longhialberto677-gif/stm32f103-foc/硬件/讲义/01-主课/00-课程进度与文件索引.md

# FOC 硬件课程 · 课程骨架（细化版）

> 讲课原则：
> ① **一节课只讲一件事**，讲透再走。
> ② 每节课都按 **遇到什么问题 → 所以要干什么 → 于是有了什么电路** 这条线。
> ③ 看不懂的地方立刻停下来重讲，不往前赶。
>
> 难度标记：🟢 轻松 / 🟡 需要动脑 / 🔴 硬骨头

---

## 进度总表

> 状态：✅ 已讲完并落盘 ｜ 📄 已落盘（合并成一个大文件） ｜ ⬜ 未讲

| 课 | 标题 | 讲什么 | 难度 | 状态 |
|---|---|---|---|---|
| **0** | MOS 管与三极管补课 | 电控开关的基础 | 🟡 | ✅ `00-MOS管与三极管补课.md` |
| — | 专题：高边低边与四种接法 | 开关装在哪里 | 🔴 | ✅ `专题-高边低边与四种接法.md` |
| — | 专题：三极管供电与 MCU 接法 | 三极管怎么接线 | 🟡 | ✅ `专题-三极管供电与MCU接法.md` |
| — | 专题：为什么 MOS 需要驱动 | 为什么要驱动芯片 | 🟡 | ✅ `专题-为什么MOS需要驱动.md` |
| **1-1** | 从哪里弄到电 + 整块板的地图 | 电池、接口、全板一览 | 🟢 | ✅ `第01课-电源输入.md` |
| **1-2** | 怎么保护自己（保险丝 + TVS） | 短路、尖峰怎么防 | 🟢 | ✅ `第1-2节-保护自己.md` |
| **1-3** | 怎么开关 + 怎么防接反（背靠背 P-MOS） | 第 0 课的实战 | 🔴 | ✅ `第1-3节-开关与防接反.md` |
| **1-4** | 把 12V 稳住（电容 + 地） | 滤波、PGND/GND | 🟡 | ✅ `第1-4节-稳住12V.md` |
| **2-1** | 为什么不能用电阻分压 | 排除错误方案 | 🟢 | ✅ `第2-1节-为什么不能用电阻分压.md` |
| **2-2** | 开关降压：12V → 5V | TPS5430 | 🔴 | ✅ `第2-2节-开关降压12V到5V.md` |
| **2-3** | 线性稳压：5V → 3.3V（数字） | AMS1117 | 🟡 | ✅ `第2-3节-线性稳压5V到3.3V.md` |
| **2-4** | 为什么要第二颗 LDO（模拟） | 干净的 3.3V | 🔴 | ✅ `第2-4节-为什么要第二颗LDO.md` |
| **3-1** | 大脑要多快 | 72MHz 从哪来 | 🟡 | 📄 `第3课-大脑.md` |
| **3-2** | 为什么必须用 TIM1 | 互补输出 + 死区 + 刹车 | 🔴 | 📄 `第3课-大脑.md` |
| **3-3** | 36 个引脚怎么分配 | 引脚规划表 | 🟡 | 📄 `第3课-大脑.md` |
| **4-1** | 3.3V 信号怎么推动 12V 的 MOS | 驱动芯片的活 | 🟡 | ✅ `第4-1节-推不动MOS怎么办.md` |
| **4-2** | 自举：上管的电从哪来 | 浮动栅压 | 🔴 | ✅ `第4-2节-自举.md` |
| **4-3** | 三相桥 + 采样电阻 | 功率级全貌 | 🟡 | ✅ `第4-3节-三相桥与采样电阻.md` |
| **5-1** | 为什么要差分放大 | 脏地上的小信号 | 🔴 | 📄 `第5课-电流采样.md` |
| **5-2** | 为什么要有 1.65V 偏置 | 负电流也要能测 | 🔴 | 📄 `第5课-电流采样.md` |
| **6-1** | 为什么时机比精度重要 | 抓拍的道理 | 🟡 | 📄 `第6课-采样时机.md` |
| **6-2** | 哪个时刻最好 | 谷底窗口 | 🟡 | 📄 `第6课-采样时机.md` |
| **6-3** | 怎么让 ADC 自动启动 | TRGO 硬件触发 | 🔴 | 📄 `第6课-采样时机.md` |
| **6-4** | 时序计算 + 三个坑 | 第一版参数 | 🟡 | 📄 `第6课-采样时机.md` |
| **7** | 屏幕、按键、LED、USB、CAN、编码器接口 | 人机与组网 | 🟢 | ✅ `第7课-外设与通讯.md` |
| **8** | 从 0 到电机转起来的调试路线 | 动手清单 + 10 个坑 | 🟡 | ✅ `第8课-调试路线图.md` |

**🎉 硬件主课已全部讲完（第 0 ~ 8 课）。**

---

## 目前位置

**硬件部分完成 ✅ → 下一步进入软件（写 FOC 代码）**

学完之后你能做到：
- 指着原理图说出每个元件"干什么、为什么在这"
- 复述"问题 → 方案 → 电路"的完整推理链
- 知道哪些地方需要核实（见 `..\FOC硬件设计讲解笔记.md` 附录 B）
- 手里有一份可执行的调试路线图（第 8 课）
- 知道自己这块板 + C2208 电机的关键参数（极对数 7、KV 120、5.3mH）

---

## 已完成的笔记文件

> 路径说明：主课在本目录 `讲义\01-主课\`；专题在 `讲义\02-专题\`；小测在 `讲义\03-小测\`。

### 主课（按 00~17 编号顺序读）

| 文件 | 对应课程 |
|---|---|
| `00-课程进度与文件索引.md` | **本文件** |
| `01-第00课-MOS管与三极管补课.md` | 第 0 课 |
| `02-第1-1节-电源输入.md` | 第 1-1 节 |
| `03-第1-2节-保护自己.md` | 第 1-2 节 |
| `04-第1-3节-开关与防接反.md` | 第 1-3 节 |
| `05-第1-4节-稳住12V.md` | 第 1-4 节 |
| `06-第2-1节-为什么不能用电阻分压.md` | 第 2-1 节 |
| `07-第2-2节-开关降压12V到5V.md` | 第 2-2 节 |
| `08-第2-3节-线性稳压5V到3.3V.md` | 第 2-3 节 |
| `09-第2-4节-为什么要第二颗LDO.md` | 第 2-4 节 |
| `10-第3课-大脑.md` | 第 3-1 / 3-2 / 3-3 节 |
| `11-第4-1节-推不动MOS怎么办.md` | 第 4-1 节 |
| `12-第4-2节-自举.md` | 第 4-2 节 |
| `13-第4-3节-三相桥与采样电阻.md` | 第 4-3 节 |
| `14-第5课-电流采样.md` | 第 5-1 / 5-2 节 |
| `15-第6课-采样时机.md` | 第 6-1 ~ 6-4 节 |
| `16-第7课-外设与通讯.md` | 第 7 课 |
| `17-第8课-调试路线图.md` | 第 8 课 |

### 专题（在 `..\02-专题\`）

| 文件 | 内容 |
|---|---|
| `01-高边低边与四种接法.md` | 附录 A |
| `02-三极管供电与MCU接法.md` | 附录 B |
| `03-为什么MOS需要驱动.md` | 附录 C |
| `04-FD6288T输出级参数与MOS桥驱动.md` | **FD6288T 六路输出的真实电压范围（手册核对）+ 驱动 MOS 桥的接法/元件取值/六条铁律**（配 `数据手册\FD6288T_Q_3-PHASE_BRIDGE_DRIVER_REV1.3.pdf`） |

### 小测与汇编成品

| 文件 | 内容 |
|---|---|
| `..\03-小测\第01课-小测与答案解析.md` | 附录 D |
| `..\FOC硬件课程讲义.docx` | **全部课程的 Word 汇编版**（带目录、页码、189 张表格） |
| `..\FOC硬件设计总笔记（按图纸分模块）.md` | 按图纸分模块的速查笔记（含"待核实疑点"附录） |
| `..\..\项目总览.md` | **根目录索引** —— 新开对话先看这个 |
