longhialberto677-gif/stm32f103-foc/硬件/讲义/02-专题/02-三极管供电与MCU接法.md

# 专题课：三极管需要供电吗？和单片机怎么接？

> 回答两个问题：
> ① 三极管要不要像 MOS 那样"给它供电"？
> ② 它和单片机（IO 口）到底怎么接？

---

## 第一部分：先直接回答第一个问题

### 一句话答案

> **三极管本身不需要"单独的电源引脚"—— 它不是芯片，没有 VCC 脚。**
> **但它控制的那个负载，需要电源（而且是它自己的电源）。**
> **电流路径是：负载的电源 → 负载 → 三极管 → 地。**

### 关键区别：芯片有"电源脚"，三极管没有

先做个对比，你就明白了：

```
【芯片】（比如 STM32、运放、驱动芯片）
   它有专门的电源引脚：VCC / VDD / V+，还有 GND
   你必须给它接电，它才能工作
   → "要供电"

【三极管 / MOS 管】
   只有三个脚：B/C/E（或 G/S/D）
   没有任何一个脚是"电源输入脚"
   → 它不需要"被供电"
   → 它是"串在别人的电路里"当开关
```

### 那电流从哪来？

**从负载自己的电源来。** 看这张图：

```
   +5V  ← 这是"负载的电源"，不是"三极管的电源"
     │
   负载（继电器/电机/灯）
     │
     C (集电极)
   [NPN]
     E (发射极)
     │
    GND

电流路径：+5V → 负载 → C → E → GND
         ↑
    三极管只是这条路上的一个"阀门"
    它不产生电流，只"放行"电流
```

> **用阀门类比：**
> **阀门本身不需要"供电"，它只是装在水管上的一个开关。**
> **水从哪来？从水泵来（= 负载的电源）。**
> **阀门的作用只是决定"让不让水流过去"。**

### 所以"给三极管供电"这句话的正确说法是：

| 错误说法 | 正确说法 |
|---|---|
| "给三极管供电" | **"给负载供电，让电流从三极管流过"** |
| "三极管的电源接哪" | **"负载的电源接哪"** |
| "三极管要几伏" | **"负载要几伏"**（三极管只关心基极那 0.7V） |

### ⚠️ 但有一个容易忽略的点：B-E 结本身需要一点点电压

三极管的 **B-E 之间相当于一个二极管**，正向压降 **0.7V**。

- 要让基极有电流，**必须给 B-E 结加上 0.7V 以上的正向电压**
- 这个 0.7V **不是"给三极管供电"，而是"打开阀门的那点力气"**
- 这 0.7V 由 **IO 口的 3.3V 提供**（经限流电阻后，B-E 结上分到 0.7V）

```
IO 输出 3.3V ──[限流电阻]── B ─(0.7V)─ E ── GND
                              ↑
                    电阻上分掉 2.6V，B-E 结上分到 0.7V
```

### 完整的"三个电源"关系（这是核心）

一个三极管电路里其实有**三个不同的电压角色**，很多人混在一起：

| # | 角色 | 电压 | 谁提供 | 作用 |
|---|---|---|---|---|
| 1 | **负载电源** | 比如 5V / 12V | 你自己的电源 | 给负载供电，电流从这来 |
| 2 | **控制信号** | 3.3V | MCU 的 IO 口 | 让基极有电流，打开阀门 |
| 3 | **B-E 结压降** | 0.7V | 由 #2 经电阻分压得到 | 只用来"开阀"，不参与负载供电 |

> **记法：#1 是"干活的力气"，#2 是"下命令的声音"，#3 是"命令的载体"。**

---

## 第二部分：和单片机怎么接？（NPN 标准接法）

### 2.1 标准电路图（一定要背下来）

```
                        +5V (或 +12V，负载自己的电源)
                         │
                      ┌──┴──┐
                      │负载 │  继电器 / LED / 蜂鸣器 / 小电机
                      └──┬──┘
                         │
                         ├──────── C (集电极)
                         │
                      [NPN]      ← 比如 S8050 / 2N3904 / S9013
                         │
     PB10 ──[1kΩ]─────── B (基极)
     (MCU的IO)           │
                         ├──────── E (发射极)
                         │
                        GND  ← 和 MCU 的 GND 必须连在一起！
```

### 2.2 三个脚的接法规则

| 三极管的脚 | 接到哪里 | 为什么 |
|---|---|---|
| **发射极 E** | **GND** | 让 B-E 结有明确的参考电位（0V） |
| **集电极 C** | **负载的一端** | 负载的另一端接正电源 |
| **基极 B** | **经限流电阻 → MCU 的 IO** | IO 的 3.3V 才能让基极有电流 |

**记忆口诀：**

> **"发射极接地，集电极接负载，基极经电阻接 IO。"**
> （NPN 低边接法，最常用）

### 2.3 ⭐ 为什么发射极必须接地？（最容易错的地方）

**因为 IO 只会输出 3.3V，而基极电流要"流进基极、从发射极流出"。**

如果发射极不接地：

```
   PB10 (3.3V) ──[1kΩ]── B
                          E ── 悬空（没接地）
                          
   → 基极和发射极之间没有回路
   → 基极电流 = 0
   → 三极管永远不导通 ❌
```

**只有当发射极接地（0V），IO 和发射极之间才有 3.3V 的电位差**，基极电流才能流动。

### 2.4 ⭐⭐ 最重要的约束：两边必须"共地"

**这是新手最容易翻车的地方。**

假设你的负载是 12V 的继电器，你用了两个独立的电源：

```
   5V电源（给MCU）        12V电源（给继电器）
        │                       │
      MCU ──[1kΩ]── B          负载
                    [NPN]        │
        GND ─────── E           C
        │                       
      ← 如果这两个 GND 不连在一起 →
      
   结果：基极回路断开 → 三极管永远不导通 ❌
```

**所以：**

```
   MCU 的 GND ──────── 负载电源的 GND   ← 必须用一根线连起来！
```

**为什么？** 因为基极电流的路径是：

```
IO(3.3V) → 限流电阻 → B → E → 负载电源的 GND → 回到 IO 的 GND
                                     ↑
                          这段路必须能走通！
```

**如果两个 GND 不连通，这条路就断了，基极没有电流。**

> ⚠️ **重要推论：三极管不做"电气隔离"。**
> **它只能"电平转换"（3.3V 控制 12V），不能"隔离"。**
> **想要真正隔离（比如市电、强干扰场合），要用光耦或继电器。**

### 2.5 PNP 三极管怎么接？（了解即可）

**方向和 NPN 相反：**

```
                         ┌──┴──┐
                         │负载 │
                         └──┬──┘
                            │
                            ├──────── C (集电极)
                            │
                         [PNP]
                            │
     PB10 ──[1kΩ]────────── B (基极)
                            │
                            ├──────── E (发射极)
                            │
                          +5V   ← 发射极接"正电源"！
```

**工作逻辑（注意：逻辑反转了）：**

| IO 输出 | V_BE | 结果 |
|---|---|---|
| **低电平 0V** | 5 − 0 = +0.7V 有电流 | **导通** ✅ |
| **高电平 3.3V** | 5 − 3.3 = 1.7V，但 B-E 结没正偏… | **截止** ❌ |

> 注意 PNP 是"低电平导通"。**如果你的 IO 输出只有 3.3V，而负载电源是 5V，用 PNP 会有问题**（3.3V 和 5V 之间只差 1.7V，不足以可靠截止）。所以 **PNP 通常用在负载电源和 IO 电压相同的情况**。

**大多数场合，直接用 NPN 就好。**

---

## 第三部分：基极电阻怎么算？（三步法）

### 3.1 为什么要算？

基极电阻决定了基极电流大小，而基极电流决定了三极管能否**完全导通（饱和）**。

- **电阻太大** → 基极电流不够 → 三极管半开 → **集电极压降大 → 发热**
- **电阻太小** → 基极电流太大 → 浪费 IO 电流（甚至烧 IO/烧管子）

### 3.2 三步法

**第一步：算负载需要多少电流**

```
例：LCD 背光 4 颗白光 LED 并联
    单颗 15mA → 总共 I_C = 60mA
```

**第二步：算需要多少基极电流**

关键：**设计时要用"饱和区的放大倍数"，不是标称的 β！**

| 区域 | 放大倍数 | 说明 |
|---|---|---|
| 放大区（线性） | β = 100~300 | 管子是"放大器"，不是开关 |
| **饱和区（开关用）** | **β_sat = 10~20** | **开关场合就用这个！** |

**为什么要用 10~20 这么小的值？** 因为要保证"深饱和"，就算管子温度变化、批次差异，也能确保完全导通。**这就是"开关用法"的标准保守设计。**

```
I_B = I_C / β_sat = 60mA / 15 = 4mA
（取个整数：需要 4~6mA 的基极电流）
```

**第三步：算电阻**

```
电阻上要分掉的电压 = IO 电压 − B-E 结压降
                  = 3.3V − 0.7V = 2.6V

R = 2.6V / I_B = 2.6V / 4mA = 650Ω

→ 取标准值 470Ω 或 680Ω（取小一点更保险）
```

### 3.3 常用经验值速查表

| 负载电流 | 建议基极电阻（IO = 3.3V） | 基极电流 |
|---|---|---|
| < 10mA | **4.7kΩ ~ 10kΩ** | 0.26~0.55mA |
| 10~30mA | **2.2kΩ ~ 4.7kΩ** | 0.55~1.2mA |
| 30~80mA | **1kΩ**（你板子背光用这个） | ~2.6mA |
| 80~200mA | **470Ω ~ 680Ω** | 4~6mA |
| 200~500mA | **220Ω ~ 330Ω** | 8~12mA |
| > 500mA | **别用三极管了，换 MOS 管** | — |

> 💡 **注意 IO 的 20mA 上限**：基极电流最好控制在 **10mA 以内**，别把 IO 的额度全用光。

### 3.4 为什么"电阻取小一点更保险"？

因为开关场合**宁可基极电流大一点（保证饱和），也不要小（导致半开发热）**：

| 基极电流 | 三极管状态 | C-E 压降 | 发热 |
|---|---|---|---|
| 不够 | **半开（放大区）** | 可能 1V 以上 | **大** ❌ |
| 足够 | **饱和** | 只有 0.1~0.3V | 小 ✅ |

`发热 = 集电极电流 × C-E 压降`。饱和时压降 0.2V，半开时可能 1V → **发热差 5 倍**。

---

## 第四部分：5 个最常见的错误

### 错误 1：基极不加限流电阻（最严重）

```
❌ PB10 ──────────────── B
                      [NPN]
              GND ───── E

B-E 结相当于一个二极管，只需要 0.7V 就导通
IO 输出 3.3V → 剩下 2.6V 全加在"极小内阻"上
→ 电流可能几百 mA → 烧 IO 或烧三极管 ❌❌
```

**必须串电阻。** 哪怕不知道算，先串个 1kΩ 也安全。

### 错误 2：忘了把两个 GND 连起来

```
❌ MCU 用 5V 电源，负载用 12V 电源，两个 GND 不连
   → 基极回路断了 → 三极管永远不导通
```

**必须共地。** 这是新手最隐蔽的错误：电路图看起来没问题，但就是不动。

### 错误 3：NPN 和 PNP 混用

| 管子 | 发射极接哪 | IO 输出什么才导通 |
|---|---|---|
| **NPN** | **GND** | **高电平**导通 |
| **PNP** | **正电源** | **低电平**导通 |

**用 NPN 做低边（发射极接地），是最常用、最省心的做法。** 别搞反。

### 错误 4：把三极管当"电压源"用

三极管**不是**让 IO"输出 12V"。它只是**让 12V 的电流能流过负载**。

```
❌ 错误理解："IO 通过三极管输出了 12V"
✅ 正确理解："IO 打开了阀门，12V 电源的电流流过了负载"
```

**证据**：如果你把 12V 电源断掉，基极给再大电流，负载也不亮。

### 错误 5：以为三极管能"隔离"

三极管**只能电平转换（3.3V 控制 12V），不能隔离**（因为两边必须共地）。

**要隔离用什么？**
- **光耦**（如 PC817）：内部是 LED + 光敏三极管，靠"光"传递信号 → 真正隔离
- **继电器**：机械触点 → 真正隔离
- **数字隔离器**（如 ADuM 系列）：磁隔离

---

## 第五部分：三极管 vs MOS，接法对比

**它们的电路结构几乎一样**，但有个关键差别：

### 5.1 结构对比

```
【三极管 NPN（低边）】              【MOS 管 N（低边）】

   +V ── 负载 ── C                    +V ── 负载 ── D
                  [NPN]                            [N-MOS]
       GND ────── E                       GND ───── E(源极)
                  B                                G(栅极)
                  │                                │
   IO ──[1kΩ]─────┘                   IO ──[10~100Ω]──┘
                                               │
                                            [10kΩ] 下拉
                                               │
                                              GND
```

**对比：**

| | 三极管 | MOS 管 |
|---|---|---|
| 控制脚 | 基极 B | 栅极 G |
| **控制方式** | **要电流**（几 mA） | **要电压**（Vgs > 10V） |
| 串的电阻 | **必须**（限流，防烧） | 建议（抑制振铃） |
| 下拉电阻 | 建议（防误触发） | **必须**（防误导通） |
| **IO 能不能直接驱动** | ✅ **能**（3.3V 够，只要限流） | ❌ **不能**（3.3V 不够，MOS 会半开） |

### 5.2 ⭐ 最关键的差别（这是你之前问的那个问题的答案）

```
三极管：IO 直接接就能用（3.3V 够开 B-E 结，只需要限流）
        → 因为它是"电流控制"，只要基极有电流就行
        → 而 0.7V 的 B-E 结，3.3V 完全够

MOS 管：IO 直接接不能用（3.3V 不够开沟道）
        → 因为它是"电压控制"，栅极要 10V 才完全导通
        → 3.3V 只能让它"半开"→ 发热烧管
        → 所以必须加"栅极驱动芯片"
```

> **一句话：**
> **三极管是"低门槛"器件 —— IO 直接能推。**
> **MOS 管是"高门槛"器件 —— 必须雇个"翻译"（驱动芯片）才能被 IO 推动。**

**这也解释了你的板子上为什么：**
- **背光用三极管** → 因为 IO 直接能推，省事便宜 ✅
- **电机用 MOS + FD6288T 驱动芯片** → 因为 MOS 门槛高，必须加驱动 ✅

---

## 第六部分：完整实例（你的板子上的 Q3）

```
                       VCC (3.3V)
                         │
                    ┌────┴────┐
                    │ LCD背光  │  4颗白光LED并联，约 60mA
                    └────┬────┘
                         │
                         ├───── C
                         │
                      [Q3 NPN]
                         │
    PB10 ──[R14 1kΩ]──── B
    (MCU IO)             │
                         ├───── E
                         │
                        GND  （与 MCU 共地 ✅）

【参数核对】
负载电流 I_C = 60mA
基极电流 I_B = (3.3V − 0.7V) / 1kΩ = 2.6mA
需要的 I_B（按 β_sat=15）= 60/15 = 4mA
实际 2.6mA < 4mA  ← 略小于"深饱和"推荐值

→ 结果：三极管会工作在"接近饱和"状态
  C-E 压降可能 0.3~0.5V（而非理想的 0.1V）
  背光会略暗一点点，三极管略有温升

→ 如果要更充分饱和：把 R14 改成 470Ω
  I_B = 2.6/0.47 ≈ 5.5mA → 深饱和 ✅
  代价：IO 多出 3mA
```

> 💡 **这是"能工作"和"工作得好"的区别。** 实际产品里 1kΩ 通常也能用（背光暗一点没人发现），但**知道了怎么算，你就有优化空间**。

---

## 第七部分：自测题

1. 三极管需要"单独的电源引脚"吗？它控制的电流从哪里来？
2. 一个三极管电路里有哪"三个电压角色"？分别由谁提供？
3. **为什么两个电源（MCU 的 5V 和负载的 12V）的 GND 必须连在一起？** 不连会怎样？
4. 为什么设计基极电阻时要用 β_sat = 10~20，而不是标称的 β = 100？
5. 三极管能"隔离"吗？如果不能，要隔离该用什么器件？
6. **为什么 IO 能直接驱动三极管，却不能直接驱动 MOS 管？**

---

## 一张图总结

```
                    三极管 = 水阀

        负载电源 ──→ 负载 ──→ [阀门] ──→ 地
        （干活的力气从这里来）    ↑
                                  │
        IO ──[限流电阻]───────────┘
        （下命令的声音从这里来，只要 2.6mA）

    ★ 阀门本身不需要"供电"
    ★ 但阀门需要"一点力气"才能打开（B-E 结的 0.7V）
    ★ 打开阀门后，流过去的水（电流）是水泵（负载电源）出的
    ★ 两个水泵的地必须接通，命令才传得过去
```
