longhialberto677-gif/stm32f103-foc/硬件/讲义/02-专题/04-FD6288T输出级参数与MOS桥驱动.md

# FD6288T 输出级参数与 MOS 桥驱动要点（数据手册核对版）

> 来源：峰岹 Fortior《FD6288T&Q 3-PHASE BRIDGE DRIVER》REV_1.3（17 页）
> 本页所有数字均来自手册正文表格，**不是估算**。
> 手册同时覆盖 **TSSOP-20（FD6288T）** 与 **QFN-24（FD6288Q）** 两种封装，电参数共用同一套。

---

## 一、"六路输出"指的是什么

FD6288T 内部是 **3 个独立半桥驱动器**，所以驱动输出是 6 路：

| 类别 | 信号 | 数量 | 参考地 |
|---|---|---|---|
| 高边输出（上管栅极） | HO1 / HO2 / HO3 | 3 | 各自的 **VS1/2/3**（浮动） |
| 低边输出（下管栅极） | LO1 / LO2 / LO3 | 3 | **COM**（固定） |

> ⚠️ 它**只输出栅极驱动电压**，不输出功率。电机电流走的是外部的 6 颗 MOS（Q1~Q6），
> FD6288T 只负责把这 6 个栅极"推"到位。

另外还有 6 个**输入**：HIN1/2/3、LIN1/2/3（来自 STM32 的 TIM1 六路 PWM），
输入与输出**同相**（in phase），且兼容 3.3V 逻辑。

---

## 二、六路输出的电压范围（核心答案）

### 2.1 一般规律：输出摆幅 = 该路的"浮动电源"到"浮动地"

```
LO 摆幅 = COM(0V) ～ VCC          ← 低边，固定
HO 摆幅 = VS1/2/3 ～ VB1/2/3      ← 高边，整体跟着相线浮动
```

手册 §推荐工作条件原文：

| 参数 | 符号 | Min | Max | 单位 |
|---|---|---|---|---|
| 低边输出 | VLO1,2,3 | **0** | **VCC** | V |
| 高边输出 | VHO1,2,3 | **VS1,2,3** | **VB1,2,3** | V |

### 2.2 你的板子（VCC = +12V）实际是多少

| 输出 | 实际电压范围 | 说明 |
|---|---|---|
| **LO1/2/3** | **0V ～ 12V** | 相对 COM |
| **HO1/2/3** | **VS ～ VS+约11.4V** | VS 从 0V 摆到约 12V，所以 HO 绝对电压是 **0V ～ 约23V** |

关键手册数据（静态特性，测试条件 VBIAS = 15V、IO = 100mA）：

| 参数 | 符号 | Typ | Max | 含义 |
|---|---|---|---|---|
| 高电平输出压降 | VBIAS − VO | **0.6V** | **0.9V** | 输出高电平 ≈ VCC − 0.45 ~ 0.6V |
| 低电平输出 | VOL | **0.3V** | 0.45V | 输出低电平接近 0V |

**所以 +12V 供电时：**

- 上管栅极相对源极：**Vgs ≈ 12 − 0.6 ≈ 11.4V**（最坏 11.1V）
- 下管栅极相对源极：**Vgs ≈ 12 − 0.3 ≈ 11.7V**
- 落在常见 MOS 的 **Vgs = ±20V** 绝对最大值之内，安全 ✅

> 📌 由此推论：**VCC 不要用 5V 去驱动功率 MOS。**
> 5V 时 Vgs 只剩 ≈4.4V，MOS 会工作在"半开"区，RDS(on) 暴涨 → 发热烧管。
> 本板用 +12V 是正确的。

### 2.3 绝对最大值（不能碰的上限）

| 参数 | 符号 | 绝对最大值 | 单位 |
|---|---|---|---|
| 低边电源 | VCC | −0.3 ～ **25** | V |
| 高边浮动电源 | VB1,2,3 | −0.3 ～ **275** | V |
| 高边浮动电源（相对 VS） | VB − VS | 正常工作 **5 ～ 20** | V |
| 高边浮动地 | VS1,2,3 | VB−25 ～ VB+0.3 | V |
| 高边输出 | VHO1,2,3 | VS−0.3 ～ VB+0.3 | V |
| 低边输出 | VLO1,2,3 | −0.5 ～ VCC+0.3 | V |
| 逻辑输入 | VIN | −0.5 ～ VCC+0.3 | V |
| 逻辑输入阈值 | VIH / VIL | **≥2.7V** / **≤0.8V** | V |
| VS 允许的电压跳变率 | dVS/dt | ≤ **50** | V/ns |

**推荐工作范围（长期可靠工作必须满足）：**

| 参数 | 范围 |
|---|---|
| VCC | **5V ～ 20V** |
| VS1/2/3 | **−4V ～ 250V**（注意：可短暂负压！） |
| VB1/2/3 | **VS+5V ～ VS+20V** |
| 环境温度 | −40℃ ～ 125℃ |

### 2.4 输出驱动能力

| 参数 | 符号 | Min | Typ | Max | 单位 |
|---|---|---|---|---|---|
| 输出拉电流（脉冲） | IO+ | 1.1 | **1.5** | 1.9 | A |
| 输出灌电流（脉冲） | IO− | 1.3 | **1.8** | 2.3 | A |

> 这就是"能一脚踹开栅极"的来源：1.8A 峰值，栅极充电时间极短，开关损耗小。

### 2.5 保护与时间参数（手册实测值）

| 参数 | 符号 | Min | Typ | Max | 单位 |
|---|---|---|---|---|---|
| 开通传播延时 | ton | — | 300 | 450 | ns |
| 关断传播延时 | toff | — | 100 | 160 | ns |
| 高/低边延时匹配 | MT | — | — | **30** | ns |
| 上升 / 下降时间 | tr / tf | — | 12 | 25 | ns |
| **内置死区** | DT | **100** | **200** | **300** | ns |
| VCC/VBS 欠压退出 | VCCUV+ | 4.2 | 4.6 | 5.0 | V |
| VCC/VBS 欠压触发 | VCCUV− | 3.9 | 4.3 | 4.7 | V |

> 内置 **交越导通保护（shoot-through prevention）+ 200ns 死区**，并且死区期间 HO 和 LO **都被强制拉低**。

---

## 三、如何驱动 MOS 桥（接线 + 参数）

### 3.1 单相半桥的完整接法

```
                 +12V 母线
                    │
              ┌─────┴─────┐
              │   Q1 上管  │  N-MOS
              └─────┬─────┘
                    ├──────── 相线 M_U ──→ 电机
                    │           │
                    │           ├────────→ VS1（高边浮动地）
              ┌─────┴─────┐     │
              │   Q2 下管  │  N-MOS
              └─────┬─────┘
                    │
                  PGND ─────────→ COM（低边地，= 芯片地）

  FD6288T
    HIN1 ←── STM32 TIM1_CH1（3.3V PWM）
    LIN1 ←── STM32 TIM1_CH1N（互补 PWM，带死区）
    HO1  ──[Rg 10~22Ω]──→ Q1 栅极
    LO1  ──[Rg 10~22Ω]──→ Q2 栅极
    VB1  ──┬── CBS（100nF~1µF，紧贴 VB1/VS1）
           └── DBS（肖特基，阳极接 +12V/VCC，阴极接 VB1）
    VS1  ────────────────→ 相线 M_U
    VCC  ──[10µF + 100nF 退耦]── +12V
    COM  ─────────────────────── PGND（单点接地）
```

三相就是把上面这套 ×3（U/V/W）。

### 3.2 三类外围元件的选取

| 元件 | 取值 | 依据 / 要点 |
|---|---|---|
| **DBS 自举二极管** | 肖特基，耐压 ≥ 母线电压，如 SS14 / SS34 | 手册明确"high reverse breakdown voltage and short recovery time 的肖特基优先"。压降低 → 自举电压更高 |
| **CBS 自举电容** | 100nF 起，MLCC 或钽电容 | 手册要求"**紧贴芯片 VB/VS 引脚**"。容值按 Qg 核算，100nF 对常规 MOS 有 10 倍以上余量 |
| **Rg 栅极电阻** | 10Ω ~ 22Ω 起调 | 手册原话："resistance depends on deadtime and the device being driven"。太小 → 振铃/EMI，太大 → 开关变慢发热 |
| **R2 栅源电阻** | 10kΩ | 手册典型电路中的 R2（MOS gate-to-source resistor），防止栅极悬空误导通 |
| **VCC 退耦** | 10µF + 100nF | 手册 C1 = 10µF，"**尽量靠近芯片引脚**" |
| **下管栅极** | LO 直接驱动 + Rg | 低边不需要自举 |

### 3.3 六条设计铁律

1. **占空比不能到 100%** —— 高边自举电容只能在下管导通时充电，必须留 3~5% 时间打水。
2. **自举二极管用肖特基**，别用 1N4007 之类慢管。
3. **CBS 紧贴 VB/VS**，DBS 走线要短。
4. **VCC 用 12V**，不用 5V（否则 MOS 半开烧管）。
5. **软件死区 + 芯片内置 200ns 死区配合**：芯片死区是最后一道防线，不是唯一。
6. **上电前几个周期先让下管导通**，把自举电容充满。

### 3.4 本板原理图核对时的关键事实

- **FD6288T 的 6 路输出是 HO1/2/3 与 LO1/2/3**，不要与 6 路输入 HIN1/2/3、LIN1/2/3 混淆。
- **VS1/2/3 必须分别接到三相相线**（不是接 GND！）——这是最常见的致命接错。
- **COM 是低边地与逻辑地**，接 PGND（本板 R43 = 0Ω 单点连到 GND 平面）。
- 高边输出 HO 的**绝对电压会到 +23V 左右**，这是正常的（自举抬压的结果），不要以为超压。
- 输出/输入都是**同相**：HIN 高 → HO 高。

---

## 四、⚠️ 需要修正的现有讲义内容

| 位置 | 现有表述 | 手册事实 | 建议 |
|---|---|---|---|
| `讲义/01-主课/05-第1-4节-稳住12V.md` 等 | "FD6288T 可能欠压保护" 未给数值 | VCC UVLO 典型 **4.3V 触发 / 4.6V 退出** | 可补上具体阈值 |
| `讲义/01-主课/11-第4-1节-推不动MOS怎么办.md` | 提到 FD6288T 能力时表述较模糊 | 输出 **1.5A 拉 / 1.8A 灌**；VCC **5~20V** | 补上"5V 下限"这个约束 |
| `讲义/FOC硬件设计总笔记` 第 239 行 | "FD6288T（1.8A / 250V / **TSSOP-20**）" | 手册 REV_1.3 中 **TSSOP-20 叫 FD6288T**，**QFN-24 叫 FD6288Q**，两者电参数相同 | 表述正确，可加一句"封装不同型号后缀不同：T=TSSOP-20，Q=QFN-24" |
| `讲义/FOC硬件设计总笔记` 第 239 行链接 | 链接指向 `fortiortech.com/en/product/hvic/hvic/fd6288` | FD6288 系列现行的**完整英文手册（REV_1.3）**可直接下载 | 建议同时存一份手册 PDF 到仓库 |

---

## 五、TSSOP-20（FD6288T）引脚表

> 依据手册 §Lead Assignments 图逐脚核对。

| 脚 | 名称 | 脚 | 名称 |
|---|---|---|---|
| 1 | HIN1 | 11 | LO1 |
| 2 | HIN2 | 12 | VS3 |
| 3 | HIN3 | 13 | HO3 |
| 4 | LIN1 | 14 | VB3 |
| 5 | LIN2 | 15 | VS2 |
| 6 | LIN3 | 16 | HO2 |
| 7 | VCC | 17 | VB2 |
| 8 | COM | 18 | VS1 |
| 9 | LO3 | 19 | HO1 |
| 10 | LO2 | 20 | VB1 |

**记忆法：** 左列 = "输入 + 电源 + 低边输出"（1~10），右列 = "低边1路 + 三相高边组"（11~20），
且 **VB/VS/HO 三兄弟成组顺序排列**（VBn 在 VS n 之上、HO n 在中间）。

---

## 六、热设计提醒（PCB 布局相关）

| 封装 | 功耗上限 PD（TA≤25℃） | 热阻 RθJA |
|---|---|---|
| **TSSOP-20** | **≤ 1.25W** | **≤ 100℃/W** |
| QFN-24 | ≤ 3.0W | ≤ 42℃/W |

**含义：** TSSOP-20 在 20kHz 下自身功耗很小（IQCC 典型 330µA），
但如果 PWM 频率拉高、或驱动大 Qg 的 MOS，芯片自身和栅极电阻上的损耗都会上升。
**GND/COM 焊盘附近要有足够的铜皮散热**，不要把 FD6288T 塞在密不透风的位置。
