longhialberto677-gif/stm32f103-foc/软件/讲义/01-主课/00-课程进度与文件索引.md

# FOC 软件课程 · 课程骨架

> 这是**硬件课之后的第二门课**：把已经焊好的板子，用代码让它真正转起来。
>
> **讲课原则（和硬件课一致）：**
> ① **一节课只讲一件事**，讲透再走。
> ② 每节课都按 **遇到什么问题 → 所以要干什么 → 于是有了什么算法** 这条线。
> ③ 每节课都给出 **推导 + 具体数字（用你这台 C2208 电机）+ 代码长什么样**。
> ④ 看不懂的地方立刻停下来重讲，不往前赶。
>
> 难度标记：🟢 轻松 / 🟡 需要动脑 / 🔴 硬骨头
>
> 硬件课的对应关系：`D:\stm32cubemx_test\myself_foc\硬件\讲义\`

---

## 一、全局图：FOC 到底在算什么

先看这张图，你不需要现在看懂，只要知道"我们要一层层爬到它"：

```
                 ┌──────────────────────── 你的代码 ────────────────────────┐
                 │                                                          │
 速度给定 ω* ──►[速度 PI]──► iq* ──┐                                        │
                                  ├─►[电流 PI]──► Ud,Uq ──►[反 Park]──► Uα,Uβ ──►[SVPWM]──► 6 路占空比
 磁场给定 id*=0 ───────────────────┘        ▲                              │
                                            │                              │
                                       id, iq ◄──[Park]◄── iα,iβ ◄──[Clarke]◄── ia,ib,ic
                                                                          ▲
                                                               ADC（TIM1 触发，谷底采样）
```

**整门课就是把这一个环，拆成 14 节课讲清楚。**

---

## 二、进度总表

> 状态：✅ 已讲完并落盘 ｜ ⬜ 未讲

| 课 | 标题 | 讲什么 | 难度 | 状态 |
|---|---|---|---|---|
| **1** | 电机为什么会转 | 转矩从哪来 / 反电动势 / 电角度 / 为什么要正弦 | 🟡 | ✅ `01-第1课-电机为什么会转.md` |
| **2** | 三相桥怎么"做出"正弦 | 半桥 = 电压源 / 占空比→电压 / 六个扇区 / 死区 | 🔴 | ⬜ |
| **3** | 从六步方波到正弦驱动 | 为什么必须正弦 / 代价是什么 | 🟢 | ⬜ |
| **4** | Clarke 变换 | 3 个量 → 2 个量（为什么能降维） | 🟡 | ⬜ |
| **5** | Park 变换 ⭐ | 把交流变成直流 —— FOC 的灵魂 | 🔴 | ⬜ |
| **6** | 电流环 | 控制 id / iq / PI 参数怎么算 / 抗积分饱和 | 🔴 | ⬜ |
| **7** | SVPWM | 35% 电压利用率是怎么多出来的 | 🔴 | ⬜ |
| **8** | 采样与标定 | 从 ADC 原始值到 ia/ib/ic 的真实电流 | 🟡 | ⬜ |
| **9** | 电角度从哪来 | AS5600 / 对齐 offset / 零位标定实操 | 🔴 | ⬜ |
| **10** | 速度环与位置环 | 双环串联 / 带宽分离 / 限幅 | 🟡 | ⬜ |
| **11** | 中断与任务调度 | 10kHz 电流环 + 1kHz 速度环怎么共存 | 🟡 | ⬜ |
| **12** | 无感（反电动势观测器） | 不用编码器怎么办（选学） | 🔴 | ⬜ |
| **13** | 整机串联 | 从零到转起来的完整数据流 | 🟡 | ⬜ |
| **14** | 保护与故障处理 | 过流/过压/堵转/失步 | 🟡 | ⬜ |

---

## 三、本课使用的固定参数（后面每节课都用它算数字）

> 来源：`硬件\项目总览.md`。这些数字**必须和你板子上的实物一致**，不一致的地方我在课里会标出来。

### 电机：东兴威 C2208（表贴式永磁，SPM）

| 项目 | 值 | 单位 |
|---|---|---|
| 极对数 $p$ | **7** | — |
| 额定电压 | 12 | V |
| 额定转速 | 1800 | RPM |
| 额定电流 | 0.8 | A |
| 最大电流 | 4.5 | A |
| 线电阻（相电阻，星形） | 21.2 | Ω |
| 相电感 | 5.3 | mH |
| 反电动势常数 $K_e$ | 0.0796 | V/(rad/s) |
| 转矩常数 $K_t$ | ≈ 0.119 | N·m/A（$=\tfrac{3}{2}K_e$，见第 1 课） |
| 编码器 | AS5600，I2C 地址 0x36，12 位绝对角 | — |

### 功率级与采样

| 项目 | 值 |
|---|---|
| 母线电压 | 12V（最大可到 24V） |
| 采样电阻 | 10 mΩ |
| 采样链路灵敏度 | 0.15 V/A（= 10mΩ × 15 倍） |
| 零电流对应 ADC | 理论 2048（1.65V 偏置），**实测为准** |
| 量程 | ±11 A |
| 目标 PWM 频率 | 10 kHz |
| 目标死区 | 1 µs |
| 目标电流环频率 | 10 kHz |
| 目标速度环频率 | 1 kHz |

> ⚠️ **一个必须注意的量纲坑**：$K_e = 0.0796$ 这个数是从铭牌"12V / 1800RPM"反推的。
> $188.5 \div 150.8 = 1.25$，正好是 25% 电压余量 → 说明 $K_e$ 算的是**相电压峰值**。
> 用示波器实测前，每节课涉及 $K_e$ 的结论都按"可能缩水"看（见第 1 课练习 3）。

---

## 四、软件课和硬件课的接口

| 硬件课上讲的 | 软件课上用它干什么 |
|---|---|
| TIM1 互补输出 + 死区 + 刹车（3-2） | 第 2 课：产生三相 PWM |
| 三相桥 + 三个采样电阻（4-3） | 第 2、8 课：电压源 + 电流反馈点 |
| 运放 15 倍 + 1.65V 偏置（5-1/5-2） | 第 8 课：ADC → 电流的换算 |
| TRGO 触发 + 谷底窗口（6-1~6-4） | 第 8、11 课：采样时机与中断 |
| 编码器 CN1 / AS5600（7） | 第 9 课：电角度 |
| 调试路线图 9 步（8） | 第 13 课：整机串联的顺序 |

---

## 五、目前位置

**硬件 ✅ 全部讲完 → 软件进行中：第 1 课已讲完。**

---

## 六、建议的动手节奏

每节课都是 **看讲义 → 回答课后问题 → 我用你的答案检查有没有真懂 → 下一课**。

不要在没搞懂第 5 课（Park 变换）的时候去写代码 —— 那是 FOC 唯一真正的分水岭，其余都是它的配套工程。
