longhialberto677-gif/stm32f103-foc/软件/讲义/01-主课/01b-重讲-反电动势.md

# 重讲第 1 课 · 第 4 步：反电动势

> 这一节是第一课的卡点。上一版讲太快了（把"转矩的分量"和"反电动势"混在一起，还先给公式）。
> 这一版**只用大白话**，一步一步来。
>
> 读法：**每一步都只有三小块** —— 遇到什么问题 → 怎么解决 → 原理是什么。
> 看不懂就把这一节发消息给我，别往下硬走。

---

## 第 0 步：先划清界限（重要）

上一版第 4 步之所以让人懵，是因为它把**两件不同的事**塞在了一起。现在拆开：

| 话题 | 回答什么问题 | 在哪讲 |
|---|---|---|
| **A. 转矩的角度分量** | 为什么是 $\sin\theta$？为什么 60° 时转矩只剩 86.6%？ | 你已经懂了，**丢开不管** |
| **B. 反电动势** | 电机转起来之后，**为什么电流自己变小了**？ | ⭐ **本节只讲这个** |

**本节完全不提夹角、不提 $\sin\theta$。** 只讲一件事：**转起来之后，电机会自己产生一个电压，跟你顶牛。**

---

## 第 1 步：一个你最熟悉的场景

### 问题

换个角度想第 3 步那个实验。之前是"通电让它自己转"——它吸住不动。

**现在反过来：不通电，你用手去拧它的轴。**

会感觉怎样？

```
   不通电，用手拧电机轴
        ↓
   你会感觉到：有点【顿顿的】，像里面灌了胶水/蜂蜜
   拧得越快，越费力
```

### 为什么？—— 因为这是一台"会发电的电动机"

**关键认识：电动机和发电机，是同一台机器，只是能量方向相反。**

| | 能量流向 | 例子 |
|---|---|---|
| 电动机 | 电 → 转 | 你的 C2208 正常工作时 |
| 发电机 | 转 → 电 | 自行车上的磨电灯（轮子转 → 灯亮）|

一台电机**天生同时具备这两种能力**。给它电它就转，你拧它它就发电。

**所以：当电机在转的时候，它一边被电流推着转，一边又在"发电"。**

它发出来的那个电，就顶着你给它的电 —— 所以叫**反**电动势（反着来的电压）。

> 💡 这个类比很准：**一边踩油门，一边有人往回拽。**
> 你踩的油门是电源电压，往回拽的力就是反电动势。

---

## 第 2 步：为什么"转"就能发电？

### 问题

"转就能发电"——凭什么？

### 原理：变化的磁场能"推"电子

这是电磁学的第一条基本定律（法拉第）：

> **只要穿过一个线圈的磁力量在变化，线圈里就会被"推"出电压。**

不用公式，看画面：

```
   ┌─────────────┐
   │  线  圈     │  ← 定子绕组（很多圈导线）
   └─────────────┘
        ↑
     磁铁在这里来回动（= 转子在转）
        ↓
   磁力量在变 → 线圈里被推出电压
```

**三种情况对比，一次就懂：**

| 情况 | 磁铁状态 | 线圈里有电压吗 |
|---|---|---|
| 电机停着 | 磁铁不动 | **没有**（磁力量一直没变）|
| 电机在转 | 磁铁一直在动 | **有**（而且转得越快，磁力量变化越快，电压越高）|

### 结论（记住这一条就够）

> **反电动势的大小 = 一个常数 × 转速**
>
> $$\boxed{e = K_e \cdot \omega}$$
>
> - 转速 $\omega = 0$ → $e = 0$（**电机停着，反电动势就是 0**）
> - 转得越快 → $e$ 越大（**一条直线，成正比**）

$K_e$ 就是"反电动势常数"，你的电机是 **0.0796 V/(rad/s)**。
意思是：**转速每增加 1 rad/s，反电动势就多 0.0796 V。**

### 数字感受一下（用你的电机）

| 转速 | 换算 | $e = K_e\cdot\omega$ |
|---|---|---|
| 0 RPM | $\omega=0$ | **0 V** |
| 400 RPM | $\omega=41.9$ | **3.3 V** |
| 800 RPM | $\omega=83.8$ | **6.7 V** |
| 1200 RPM | $\omega=125.7$ | **10.0 V** |
| ≈1440 RPM | $\omega=150.8$ | **12.0 V** ← 等于电源电压，**到顶了** |

（换算：$\omega = 2\pi n/60$，$n$ 是 RPM）

**看最后一行。** 这就是本节所有结论的来源，下面正式讲。

---

## 第 3 步：反电动势带来的第一个后果

### 问题

现在电机在转，反电动势 $e$ 已经产生了。**它跑到哪里去了？**

### 怎么解决 / 原理：它是"反着接的一节电池"

画个电路图（单相，简化）：

```
             电源 U（驱动器给的）
                 │
        ┌────────┴────────┐
        │                 │
       ─┴─ 反电动势 e    ─┴─ 绕组电阻 R
       ─┬─ （反着接！）    ─┬─
        │                 │
        └────────┬────────┘
                 │
             回到电源
```

**看那个"反着接"**：反电动势的正极，正好顶在电源的正极上。

所以真正推着电流走的电压，**不是 $U$，而是 $U - e$**：

$$\boxed{\;i = \frac{U - e}{R} = \frac{U - K_e\omega}{R}\;}$$

**这个式子能一口气解释三个你一定会遇到的现象。** 用你的数据（$U=12$V，相电阻 $R=10.6\Omega$）算：

| 状态 | 转速 | $e$ | 实际推电流的电压 $U-e$ | 电流 |
|---|---|---|---|---|
| **堵转**（按住不让转）| 0 | 0 V | **12.0 V** | **1.13 A** ← 最大！|
| 慢慢转 | 400 RPM | 3.3 V | 8.7 V | 0.82 A |
| 转起来 | 800 RPM | 6.7 V | 5.3 V | 0.50 A |
| 转很快 | 1200 RPM | 10.0 V | 2.0 V | 0.19 A |
| **顶到头** | 1440 RPM | **12.0 V** | **0 V** | **0 A** ← 一滴电流都进不去 |

### 现象 1：为什么电机一转起来，电流自己变小了？

上表明明白白：**转速越高，$e$ 越大，留给电流的电压 $(U-e)$ 越小。**

> 通俗版：**电机转得越快，"顶牛"顶得越凶，电流被顶住了。**

（很多人第一次看到"电机一转，电流反而小了"会觉得奇怪 —— 一点都不奇怪，因为它开始发电了。）

### 现象 2：为什么堵转会烧电机？

电机停着不转（$e=0$），**全部 12V 都用来产热了**，电流达到最大值 1.13A。

$$P = i^2R = 1.13^2\times10.6 \approx 13.6\ \text{W} \quad(\text{全变成热})$$

> 通俗版：**电机一停，"顶牛"的力量消失，电流失去约束，全部变成热量。**
> 所以"堵转"是电机最危险的工况。你的驱动器必须有堵转保护（第 14 课）。

### 现象 3：⭐ 为什么有转速上限？

$e = 12$V 时，$U - e = 0$ → **电流为零 → 转矩为零 → 再也加不了速**。

> ⭐ **这就是最高转速的物理来源：反电动势追上了电源电压。**
>
> $$\omega_{max} = \frac{U}{K_e}$$

**通俗版：你踩油门，对方往回拽的力越来越大。你油门踩到底，对方也拽到一样大 —— 车就再也快不了了。**

**用你的电机算：** $\omega_{max} = 12/0.0796 = 151\ \text{rad/s} \approx 1440$ RPM。

> ⚠️ 留个心眼：这 1440 RPM **小于**电机标称的 1800 RPM。说明 $K_e$ 记的量纲（峰值？RMS？线电压？）需要实测确认。
> **但结论本身不变：12V 母线跑不满额定转速，想跑满要升压到 24V。**（课后作业会实测校准）
> 而且实际只会更低：控制器有死区损失、MOS 有压降、PI 还要留余量 → 估计**实测能到 1200 RPM 就不错**。

---

## 第 4 步：这会毁掉 FOC 吗？（关键转折）

### 问题

现在有个新麻烦。回忆 FOC 的工作方式：

```
   我给电流环下命令："维持 iq = 0.5 A！"
        ↓
   电流环的 PI 控制器发现：电流不够 → 自动把电压 U 往上抬
        ↓
   好，电流确实到 0.5A 了……
```

**但如果转速慢慢升高呢？** $e$ 在涨，$(U-e)$ 在缩水，电流开始往下掉。PI 发现电流掉了，**继续抬 U**……

**这个"PI 自动抬电压"的过程，能不能一直抬下去？**

### 答案：不能，它会撞墙 ⚠️

因为 $U$ **最多只能到母线电压 12V**。PWM 占空比最大 100%，给不出比母线更高的电压（除非用升压电路）。

**所以会发生这个连锁：**

```
   转速升高 → e 升高 → 电流掉 → PI 拼命抬 U
        ↓
   U 抬到 12V，撞墙！
        ↓
   电流还是不够 → PI 的积分项一直累加（饱和）
        ↓
   电流【永远达不到你要的值】 → 转矩不够 → 转速上不去
```

### 具体算给你看（用你的电机，这一步很反直觉）

假设你命令 $i_q^* = 4.5$A（标称最大电流）。要在堵转时达到 4.5A，需要多少电压？

$$U = R\cdot i = 10.6 \times 4.5 = \mathbf{47.7\ V}$$

**但母线只有 12V，差了 4 倍。** 所以：

> **你命令 4.5A，实际最多只能得到约 1.13A。**

**这不是代码写错了，是物理不允许。** 电机 21.2Ω 的线电阻太高了。

**通俗版：** 你让 PI 去搬一个 50 公斤的箱子，PI 很努力，但它只有 12 公斤的力气。它会把吃奶的劲都使出来（电压拉满），箱子还是一动不动（电流上不去）。

### 对你的三个直接影响（记下来，后面要用）

| # | 影响 | 出现在哪一课 |
|---|---|---|
| 1 | **电流环必须有"抗积分饱和"**，否则 PI 会疯掉（积分数值涨到天上，想降速时反应不过来）| 第 6 课 |
| 2 | **过流保护设 4.5A 等于没设**（永远触发不了）。按实际可达的 **1~1.5A** 去设才有意义 | 第 14 课 |
| 3 | **12V 母线转速上限约 1440 RPM**（实际更低）。想冲高速 → 换 24V 供电 | 第 10 课 |

---

## 第 5 步：本节的另一种用法 —— 反电动势能当传感器！

### 问题

上面讲的都是反电动势的"坏处"（顶牛、限速、撞墙）。**它有没有好处？**

### 有！而且是一个巨大的好处

回到第 2 步的公式：

$$e = K_e\cdot\omega \quad\Longrightarrow\quad \boxed{\omega = \frac{e}{K_e}}$$

**注意：反电动势的大小，直接反映了转速！**

再进一步：反电动势的**波形**跟转子位置是锁定的（转子转到哪，波形就到哪一相）。

> ⭐ **所以：测量反电动势，就能反推出转子的转速和位置 —— 不需要编码器。**
>
> **这就是"无感 FOC"（sensorless FOC）的全部原理。**

它甚至决定了无感的**先天缺陷**，现在就顺便理解掉：

| 转速 | $e$ 大小 | 能不能用它估位置 |
|---|---|---|
| 0（停着）| **0 V** | ❌ **完全测不出来** |
| 很慢（比如 30 RPM）| 0.25 V | ❌ 太小，淹在噪声里 |
| 快了（600+ RPM）| 5 V 以上 | ✅ 好用 |

> **通俗版：转得越慢，反电动势越小，越"看不见"位置。**
> **所以无感 FOC 在低速时不能用 —— 起步必须靠别的办法（开环强拖、高频注入）。** 这就是所有无感驱动器"起步困难"的根本原因。

**你的板子有 AS5600 编码器** → 你有真实位置，**可以完全跳过这些麻烦**，先把有感 FOC 跑通（第 9 课）。无感是第 12 课的选学内容。

---

## 第 6 步：本节的坑清单

| # | 坑 | 正确认识 |
|---|---|---|
| 1 | "电机通了电就该有电流" | 电机的电流是 $(U-e)/R$，**转起来之后会自己变小** |
| 2 | "$K_e$ 就是个常数，直接除就行" | ⚠️ **量纲极易搞错**：峰值/RMS？线电压/相电压？差 $\sqrt2$ 或 $\sqrt3$。**必须实测校准** |
| 3 | "电流环能给出任意大电流" | ❌ 电压被母线卡死。**你的电机 12V 下最多约 1.13A** |
| 4 | "转速上限是电机标称的 1800 RPM" | ❌ 是 $\omega_{max}=U/K_e$ 算出来的，**12V 下约 1440 RPM** |
| 5 | "堵转只是不转，没危险" | ❌ 堵转 = $e=0$ = 电流最大 = **全变热**，最危险的工况 |

---

## 第 7 步：自测（答不上来就再读一遍，别往前赶）

1. 电机**停着**不通电，你用手拧它的轴，有没有反电动势？通电但**堵住不让转**，有没有反电动势？
2. 转速翻倍，反电动势怎么变？电流怎么变（电源电压不变时）？
3. 为什么"堵转最危险"？用 $e$ 解释。
4. 我给你 24V 供电，$K_e=0.0796$ 不变，理论最高转速是多少 RPM？（对比 12V 时的 1440）
5. 无感 FOC 为什么"起步困难"？用 $e=K_e\omega$ 解释。
6. 我命令电流环要 4.5A，为什么它给不了？

<details>
<summary>自检答案（先自己答）</summary>

1. 停着不通电你拧它 → **有**（转子在动，磁通在变）。通电但堵住不转 → **没有**（$\omega=0 \Rightarrow e=0$）。
2. 反电动势**翻倍**；电流**变小**（因为 $U-e$ 变小）。
3. 堵转时 $e=0$，电源电压全部压在电阻上，电流达到最大值，$P=i^2R$ 全部变成热 → 烧绕组。
4. $\omega_{max}=24/0.0796=301.5$ rad/s → $n = 301.5\times60/(2\pi) = \mathbf{2879\ RPM}$。翻倍多一点（因为 24/12 = 2，但转速上限正比于 $U$，所以理论正好 2 倍 = 2880）。
5. 因为 $e=K_e\omega$，转速越低 $e$ 越小；零速时 $e=0$，**完全没有位置信息** → 无法知道该给什么相位 → 只能用开环强拖或高频注入起步。
6. 因为要达到 4.5A 需要 $U=R\cdot i=10.6\times4.5=47.7$V，而母线只有 12V，**电压饱和**，PI 抬到顶也到不了。

</details>

---

## 第 8 步：动手验证（有个不用示波器的版本）

### 问题

说了半天"反电动势"，**你亲眼见过它吗？** 没见过的东西，学了就忘。

### 方法 A：有示波器（最准）

1. 电机三根线**全部悬空**（千万别接驱动器！否则驱动器会干扰读数）
2. 用示波器探头量**任意两根线之间**，探头地夹另一根线
3. 用手/电钻**匀速**转转子，看波形

**要观察三件事：**
- 波形是**正弦**（→ 这是 PMSM，FOC 的正统对象）还是**梯形平顶**（→ BLDC）？
- **慢慢转一圈，数波形有几个周期** → 应该 = 极对数 = **7**（这是验证极对数最快的方法）
- 转到已知转速，记峰峰值 $V_{pp}$

### 方法 B：只有万用表（也能做！）

**用一个直流档就能看出"它真的在发电"：**

1. 万用表打到**直流电压档**（20V 或 200V）
2. 表笔搭在任意两根线上，电机三线悬空
3. **用手匀速拧轴**

**你会看到：数字随着你转得快慢在变化 —— 转得快读数大，转得慢读数小。**

这一条就足以证明：**没有接任何电源，它自己产生了电压。** 反电动势亲眼见到了 ✅

**顺便验线性（最关键的验证）：**

- 慢慢转，记读数 → ____ V
- **用两倍速度**转（心里数拍子，或让电钻换档），记读数 → ____ V

> **读数应该大致翻倍。** 这就验证了 $e = K_e\omega$ 是**正比关系**——本节最核心的那条公式，你用万用表就证明了。
>
> ⚠️ 万用表直流档读的是**绝对值平均值**，不是峰值，所以**不能拿这个数直接算 $K_e$**（正弦波差 $\frac{\pi}{2\sqrt2}\approx1.11$ 倍，而且相电压和线电压还差 $\sqrt3$ 倍）。
> **它的用途只有一个：证明"转速 → 电压"成正比。** 要精确的 $K_e$ 还是得示波器，或者干脆用程序自己量（第 9 课会教）。

**做完把两个读数发我**，我帮你判断这电机到底是正弦还是梯形、以及要不要调整后面的参数。

---

## 一句话总结本节

> **电机一转，就变成发电机；它发出来的电压反着顶住电源 —— 这就是反电动势。**
> - 它让**电流随转速下降**（所以堵转最危险）
> - 它决定了**转速上限** $U/K_e$（12V → 约 1440 RPM）
> - 它会**撞墙**（母线电压到头，PI 再也抬不上去 → 4.5A 要不到）
> - 但它也能当**传感器**（测它就知道转速和位置 → 无感 FOC）
