longhialberto677-gif/stm32f103-foc/硬件/讲义/05-练手项目/99-备查资料/03-设计参数核对表.md

# 设计参数核对表（自动计算）

基准 VREF=1.221V ｜ fsw=500kHz ｜ 输入 6.0~24.0V ｜ 每路 3.0A

## 一、反馈分压与输出电压

| 输出轨 | R_top | R_bot | 计算输出 | 误差 |
|---|---|---|---|---|
| 5V | 10.00kΩ | 3.24kΩ | 4.990V | -0.21% |
| 3.3V | 5.10kΩ | 3.00kΩ | 3.297V | -0.10% |
| ADJ12V | 10.00kΩ | 1.13kΩ | 12.026V | +0.22% |

## 二、电感纹波与峰值电流（最坏工况 Vin=24V）

| 输出轨 | L | 纹波 ΔI_L | 峰值电流 | 谷值电流 | 需要 Isat> |
|---|---|---|---|---|---|
| 5V | 15.0µH | 0.53A (p-p) | **3.26A** | 2.74A | 4.2A |
| 3.3V | 10.0µH | 0.57A (p-p) | **3.28A** | 2.72A | 4.3A |
| ADJ12V | 15.0µH | 0.80A (p-p) | **3.40A** | 2.60A | 4.4A |

> 电感 DCR 也参与发热：3A 时 DCR=30mΩ → 损耗 0.27W；DCR=100mΩ → 0.9W（差 3 倍）。

## 三、占空比与极限（最坏工况）—— ⭐ 这一节决定了输入电压的可用范围

路径固定压降（3A 满载）：OR级 40mV + 电感 90mV + 内部MOS 300mV = **430mV**

| 输出轨 | Vin=24V 时 D | Vin=6V 时 D | **跑 3A 所需最低 Vin** | 判定 |
|---|---|---|---|---|
| 5V | 20.8% | 83.3% | 6.24V | ❌ 需要 ≥6.2V |
| 3.3V | 13.7% | 55.0% | 4.29V | ✅ 6V 输入可以 |
| ADJ12V | 50.0% | 200.0% | 14.29V | ❌ 需要 ≥14.3V |

> 判定标准：D 超过约 87%（最大占空比，受最小关断时间约 150ns 限制）就撑不住。
> ⚠️ **所以 ADJ 轨的高压档会受输入限制** —— 12V 输出需要输入 ≥15V 才稳。
> 这是「通用可调」模块的铁律：**Vout 最高只能做到 Vin × 0.85 左右**。

## 四、输入电容 RMS 纹波电流（每路各自需要）

| 输出轨 | Vin=6V 时 D | I_Cin(rms) | 需要电容 |
|---|---|---|---|
| 5V | 83.3% | 1.12A rms | ≥2 颗 10µF/50V X7R 并联 |
| 3.3V | 55.0% | 1.49A rms | ≥2 颗 10µF/50V X7R 并联 |
| ADJ12V | 200.0% | 0.00+4.24jA rms | ≥2 颗 10µF/50V X7R 并联 |

> 最坏情况出现在 D=0.5，此时 I_Cin(rms) = Iout/2 = 1.5A。

## 五、输出纹波（容性分量）

| 输出轨 | 输出电容 | ΔI_L | 容性纹波 ΔV |
|---|---|---|---|
| 5V | 94µF | 0.53A | 1.4mV |
| 3.3V | 94µF | 0.57A | 1.5mV |
| ADJ12V | 122µF | 0.80A | 1.6mV |

## 六、效率与损耗（5V/3A 轨，Vin=12V / 24V）

- **Vin=12V**：D=42% ｜ 二极管 0.79W + 高边MOS 0.38W + 开关 0.36W + 电感 0.27W + 静态 0.04W = **总损耗 1.83W → 效率 ≈ 89.1%**
- **Vin=24V**：D=21% ｜ 二极管 1.07W + 高边MOS 0.19W + 开关 0.72W + 电感 0.27W + 静态 0.07W = **总损耗 2.32W → 效率 ≈ 86.6%**

> ⚠️ 结论：**续流二极管是最大单一热源**（约 1W），其次才是芯片内部。
> 这也是为什么第 5 步升级同步整流能一次砍掉效率的最大瓶颈。

## 七、温升估算（不同散热条件）

| θJA（散热条件） | 损耗 1.8W 时温升 | 结温(环境25°C) | 判定 |
|---|---|---|---|
| 70°C/W（小铜皮、无过孔）| 126°C | 151°C | ❌ 会过温保护 |
| 55°C/W（一般铺铜）| 99°C | 124°C | ⚠️ 偏高 |
| 40°C/W（大铜皮+过孔阵列）| 72°C | 97°C | ✅ 安全 |
| 32°C/W（大铜皮+过孔+风扇）| 58°C | 83°C | ✅ 安全 |

> TPS5430 结温上限 150°C，但工程上建议 **< 110°C**（留寿命余量）。
> **这就是为什么必须打过孔 + 大面积铜皮 —— 同样的电路，温升能差 70°C。**

## 八、保护链参数

| 项目 | 计算 | 选型 |
|---|---|---|
| 满载输入电流（24V→三路满载） | Pout=5*3+3.3*3+12*3=60.9W，按 85% 效率 → Iin=2.99A | 保险丝 **4A 慢断** |
| 最坏输入电流（6V 输入、三路满载） | 12.0A | ⚠️ 6V 输入跑不了三路满载，见第四节的 D 判定 |
| 输入总电容 | 3 路 × ≥1.5A rms | 470µF/35V 电解 + 10µF/50V X7R ×6 |
| TVS 钳位 | 输入上限 24V × 1.35 ≈ 32.4V | **SMBJ33A**（33V 击穿，钳位 <53.3V） |
| OR 用 P-MOS | 3A × 13mΩ = 39mV，损耗 0.117W | **AO4407A**（30V/12A/13mΩ）|
| 每路输出 PTC（可选） | 额定 3A → 选保持电流 1.5~2A | 保护负载侧短路 |
