longhialberto677-gif/stm32f103-foc/硬件/讲义/05-练手项目/课程/第1课-电从哪进来.md

# 第 1 课：电从哪进来

> 全书一共 9 课，一课一个文件，一课只讲一件事。
> **看完告诉我"继续"，我才写第 2 课。**

---

## 今天只讲一件事

**输入接口 = 电源插座 + 接线端子，两个都装。**

---

## 一、为什么要两个

```
   桌面适配器 → [DC 母座]  ──┐
                             ├── 合并 ──→ 后面的电路
   电池/大电流 → [接线端子] ──┘
```

| 接口 | 好处 | 坏处 |
|---|---|---|
| **DC 母座** | 随手插拔，像成品模块 | 电流只能到约 **2A** |
| **接线端子** | 电流大、接得牢 | 每次要螺丝刀 |

**两个都装 = 既能随手插，也能接电池。**

不用做切换开关 —— 两个同时插着也不会打架（后面的课会讲为什么）。

---

## 二、DC 母座只有一个地方容易买错

**外径都是 5.5mm，区别在中心针多粗：**

```
   ┌─────────────┐
   │   ● ← 中心针  │     内径 2.1mm（母座标 2.0）
   └─────────────┘          或
                            内径 2.5mm
```

| 你的适配器插头 | 要买哪种母座 |
|---|---|
| 5.5 × **2.1** mm（最常见） | **DC-005-2.0** ← 就用这个 |
| 5.5 × **2.5** mm | DC-005-2.5 |
| 3.5 × 1.35 mm（小板子那种） | 插不进去，不通用 ❌ |

> ⚠️ 母座标"2.0"、插头标"2.1" —— 这俩是**同一对**，不是两套规格。

**另一个必须记住的：中心针是正极（+），外壳是负极（−）。**

---

## 三、今天的小任务（30 秒）

拿出你手边的 12V 适配器插头，**用卡尺或直尺量一下中心孔的内径**，或者直接插一个已知的母座试试。

告诉我：**是 2.1mm 还是 2.5mm？**

- 是 2.1 → 第 2 课直接照 `DC-005-2.0` 往下走 ✅
- 是 2.5 → 我们改买 2.5mm 版本
- 手上没有 → 就说"没有"，我按最常见的 2.1 定

---

## 本课小结（就这三行）

```
① 输入接口用两个：DC 母座 + 接线端子
② DC 母座买 2.0mm 版本（配 5.5×2.1 插头）
③ 中心针 = 正极
```
