longhialberto677-gif/stm32f103-foc/硬件/讲义/05-练手项目/课程/第5课-拆解FOC的输入电路.md

# 第 5 课：你抄的这块电路，我拆给你看

> 你照着 FOC 板抄的是它的**电源输入电路**。
> 抄得对 —— 但**有 4 个地方必须改**，因为你的模块要跑 24V，而 FOC 板只跑 12V。
> 另外：**我上一课给你的电阻建议不完全对，这课更正。**

---

## 一、先认电路：这是你 FOC 板的东西

| 你图上的元件 | 它是干什么的 | FOC 板上有 |
|---|---|---|
| **CN3 = XT30PW-M** | 主电源接口（航模插头） | ✅ 同一颗 |
| **F2 = BSMD1812-300-12V** | 自恢复保险丝（PTC） | ✅ 同一颗 |
| **D9 = SMF15CA** | 双向 TVS，吸收浪涌 | ✅ 同一颗 |
| **Q6/Q7 = NCE30P12S** | 背靠背 P-MOS：总开关 + 防反接 | ✅ 同一颗 |
| **R39 = 2.2kΩ** | 栅源电阻：保证**默认关断** | ✅ 同一颗 |
| **R40 = 1kΩ** | 栅极串联电阻：**保护开关触点** | ✅ 同一颗 |
| **U9 = SS-12D06** | 手拨开关：手动开机/关机 | ✅ 同一颗 |
| **C28/29/30** | 470µF + 10µF ×2 输入滤波 | ✅ 同一套 |
| **R43 = 0Ω** | PGND 和 GND 单点相连 | ✅ 同一颗 |

**所以你不是"随便抄的"，你抄的是一套已经验证过的成熟电路。这个选择是对的。**

---

## 二、⚠️ 先更正我上一课的错误

上一课我说：
> ~~R39 改成 100kΩ、R40 改成 10kΩ~~

**这个建议不完全对。** 你的 FOC 讲义 `04-第1-3节-开关与防接反.md` 里写得比我准：

### R39 = 2.2kΩ，两个作用，都不能用 100k 替代

```
作用 1：栅源电阻 —— 保证"默认关断"
   关门时：栅极经 R39 被拉到【源极电位】→ Vgs = 0V → 可靠截止 ✅
   （所以 R39 必须接在 栅极—源极 之间，不是栅极—地！）

作用 2：和 R40 组成分压 —— 决定导通时 Vgs 有多负
   开门时：栅极 = 12V × 1k/(2.2k+1k) = 3.75V
          Vgs = 3.75 − 12 = −8.25V  → 足够完全导通 ✅
```

### R40 = 1kΩ，它的作用是**保护开关触点**（我上一课漏掉了）

```
栅极是个电容。开关 U9 闭合的瞬间，要给栅极电容充电。

没有 R40 → 开关触点承受巨大瞬时电流 → 打火、烧蚀、氧化 ❌
有 R40   → 限制充电峰值电流 → 保护触点 ✅
```

> ⭐ **两个电阻的分工（记住这张表）：**
> | 电阻 | 位置 | 作用 |
> |---|---|---|
> | **R39 = 2.2kΩ** | 栅极 ↔ **源极** | 保证默认关断 + 参与分压定 Vgs |
> | **R40 = 1kΩ** | 栅极 ↔ 开关 ↔ PGND | 限制栅极充电电流，保护触点 |
>
> **所以 2.2k / 1k 是配套设计，不是随便填的数。你要照抄就连数值一起抄。**

---

## 三、这个电路的妙处：它是个"自供电的逻辑"

**为什么不需要任何控制芯片，就能同时做到"开关"和"防反接"？**

关键一句话：**栅极永远是 0V（因为 U9 接到地），而源极电压取决于"接对了还是接反了"。**

| 状态 | U9 | 接线 | 公共源极 | 公共栅极 | Vgs | MOS | 结果 |
|---|---|---|---|---|---|---|---|
| **关机** | 断开 | 正接 | ≈12V | ≈12V（经 R39） | **0V** | 关 | 输出没电 |
| **开机** | 闭合 | 正接 | ≈12V | **0V** | **−12V** | **开** | +12V 上线 |
| **保护** | 闭合 | **反接** | ≈0V | 0V | **0V** | 关 | 输出没电 ✅ |

**"接反时自动不导通"是怎么来的？** —— 源极被体二极管钳到 0V，栅极也是 0V，于是 Vgs = 0V，不满足导通条件。**电路自己就认出了极性。**

> ⭐ **这就是"好的电路设计"：不靠软件判断，靠拓扑本身。**

---

## 四、⚠️ 但你的模块要跑 24V，这 4 个地方必须改

**FOC 板是 12V 系统，你的模块是 6~24V。抄过来的东西要重新核一遍：**

| # | 元件 | FOC 板的规格 | 用在 24V 会怎样 | 改成什么 |
|---|---|---|---|---|
| **1** | **F2** PTC | `BSMD1812-300-12V`：**3A 保持 / 12V** | **12V 额定电压不够**，24V 下会击穿/失效 ⚠️<br>而且保持电流 3A 太小（你满载输入 2.95~5.9A）→ 正常就跳 | 保持 **6A** / 耐压 **≥30V** 的 PTC<br>（如 BSMD 系列 30V 档，或直插 PTC） |
| **2** | **D9** TVS | `SMF15CA`：15V 截止 / 18.5V 击穿 / 24.4V 钳位 | **24V 输入时它会一直导通** → 持续发热 → 烧毁 ⚠️⚠️ | **SMF33A** 或 **SMBJ33A**<br>（33V 截止，钳位 53V） |
| **3** | **C28** 电解 | 470µF（FOC 板用 25V 档） | 24V 输入时**击穿** ⚠️ | **470µF / 35V**（105°C） |
| **4** | **Q6/Q7** | NCE30P12S：**30V** / 12A / 8~16mΩ | 24V ÷ 30V = 余量只有 **1.25 倍**；浪涌靠 TVS 兜底 | 能用，但**想更稳就换 40V**（如 SI4459BDY） |

> ⚠️ **第 2 条最危险**：TVS 的"截止电压 15V"意思是"15V 以下不漏电"。
> 你给它 24V，它就**一直处在击穿导通状态** → 变成一个大功率发热电阻 → 烧掉。
> **这不是"保护失效"，是"元件本身会烧"。**

---

## 五、你模块的输入级（照这个改）

```
   DC座(+) ──┐
             ├──[PTC 6A/30V]──[TVS 33V]──┬── S[Q6]D ──┬── D[Q7]S ── +12V
   端子(+) ──┘                            │            │
                                          │      公共源极
                                     （栅极网络）
                                          │
                              公共栅极 ──[R40 1kΩ]── U9 ── GND
                                  │
                              [R39 2.2kΩ]
                                  │
                              公共源极

   +12V ──┬── C28 470µF/35V
          ├── C29 10µF/50V
          └── C30 10µF/50V
                │
              PGND ──[R43 0Ω]── GND
```

> **两个输入接口怎么合并？** 你的 FOC 板只有一个 XT30，而你要两个接口。
> **合并方法下一课讲**（提示：和 Q6/Q7 是同一类思路，但要多一层）。

---

## 六、本课总结（四行）

```
① 你抄的是 FOC 板的"电源输入电路"，一套成熟方案，抄得对
② R39 = 2.2kΩ（栅极↔源极，保证默认关断）+ R40 = 1kΩ（保护开关触点）是配套设计，连数值一起抄
③ 这个电路的妙处：栅极永远 0V，源极电压反映"接对没接对" → 自动识别极性，不需要芯片
④ 改成 24V 必须换 4 样：PTC（6A/30V）、TVS（33V）、电解（35V）、MOS 考虑换 40V
```

## 本课的任务（1 分钟）

```
[ ] 打开你的 FOC 板原理图，对照本文第一节的表格，确认这 9 个元件你都抄对了
[ ] 检查你的 TVS 是不是 SMF15CA —— 如果是，记下来要换成 33V 的
[ ] 检查你的 PTC 型号里的电压数字 —— 如果是 12V，记下来要换
[ ] 检查 C28 电解的耐压标注
```
