longhialberto677-gif/stm32f103-foc/变更记录/README.md

# 变更记录

每次实质性改动一个文件夹，记录"改了什么、为什么、怎么验证的"。

| 编号 | 变更 | 日期 | 关键词 |
|---|---|---|---|
| 01 | [中断占用率饱和分析](01-中断占用率饱和分析/) | 2026-10-09 | DWT 测中断占用率；20kHz FOC 中断吃满 CPU（99.25%）；VOFA 波形与 LED 劣化；马鞍波形状验证 |
| 02 | [控制环触发架构改造](02-控制环触发架构改造/) | 2026-10-09 | FOC 触发从独立 TIM4 改为 TIM1_CH4 比较中断；相位锁死在载波上；软件 &1 分频到 10.204kHz；CPU 97.7% → 53.4% |
| 03 | [除法换倒数](03-除法换倒数/) | 2026-10-09 | SVPWM 三次软浮点除法折成常量；单次 FOC 3574 → 2654 cycle；控制延迟 74 → 49.5 µs；反推每次除法 ≈ 307 cycle |
| 04 | [V/F 开环速度控制](04-VF开环速度控制/) | 2026-10-09 | 斜坡+角度积分替换固定步长；修掉角度回绕的双精度 fmod（612 cycle）；CPU 55.6% → 46.9%，延迟回 49.5 µs；VOFA 实测调速正常 |
| 05 | [AS5600 编码器接入](05-AS5600编码器接入/) | 2026-10-09 | 按 G431 分工接入编码器（定点换算约 30 cycle vs 浮点 1100）；I2C 排障：坏芯片 + ErrorCode 假象 + 地址扫描定位；零点标定 Vd 轴对齐；限频 1kHz，中断占用 46.9% → 30.0% |
| 06 | [角度刻度统一与编码器闭环](06-角度刻度统一与编码器闭环/) | 2026-10-09 | V/F 改 Q16 定点（回绕靠溢出，软浮点 13 → 9）；两路角度统一成"一圈=65536"，切角度源一行搞定；Theta_Mode 三档 + 按键；单次 FOC 1922 → 1844 cycle；三步走完成 |
| 07 | [角度预测](07-角度预测/) | 2026-10-09 | DWT 时间戳 + 实测转速（先跨圈再乘增益 + 低通）+ 角度预测（含执行器提前量）；滞后与转速严格线性（7.64 counts/rpm vs 理论 7.65）；A/B 实测 +1.7%（理论 2.6%）；白送速度估计；真正价值是闭环相位裕度；顺带清理死代码 + 波特率 460800 |
| 08 | [微分跟踪器 TD](08-微分跟踪器TD/) | 2026-10-13 | 二阶线性 TD 做 Vq 软启动；Q16/Q20 定点化，CPU **12.8% → 0.45%**（28 倍）；分频到 1kHz；参数热更新（125ms）；**"改 ωn 没效果"的三个原因**；ωn↔上升时间表（最终 20）；GBK→UTF-8 |

## 目录约定

每个变更一个文件夹，编号递增、不复用，文件夹内含三样：

- `NN-<名称>.md` —— Markdown 版，便于 `git diff` 与在 GitHub 网页上直接阅读
- `NN-<名称>.docx` —— Word 版，**图片已内嵌**，便于阅读、打印、单独发送
- `img/` —— 原始截图，上面两个版本都引用这里的图

## 怎么加一条新记录

1. 新建 `NN-<名称>/`，编号取现有最大值 +1
2. 截图放进 `img/`，正文按"**现象 → 数据/证据 → 根因 → 待确认 → 下一步**"写；配图用 `![图注](img/xxx.png)` 引用（这样 GitHub 网页上也能直接看到图）
3. 生成 Word 版（图片会自动内嵌，不依赖外部文件）：

   ```powershell
   pwsh tools/md2docx.ps1 -Md "变更记录/NN-<名称>/NN-<名称>.md"
   ```

   脚本直接驱动 Word COM 建文档，不需要 pandoc 等外部工具，输出同名 `.docx` 并自动校验图片确实进了 `word/media`。
4. 在本文件顶部表格里加一行

> 注意：`.docx` 里的图片是内嵌的，所以两份文档内容重复是**故意的**——`.md` 服务于 git 版本管理，`.docx` 服务于阅读和分享。改了 `.md` 记得重跑一次第 3 步。
