longhialberto677-gif/stm32f103-foc/软件/讲义/01-主课/01-第1课-电机为什么会转.md

# 第 1 课：电机为什么会转

> 难度 🟡。这是软件课的第一节。
> 这节课**不写一行代码**，但它是后面 13 节课的地基 —— 如果这节课没听懂，第 5 课的 Park 变换就是天书。

---

## 第 1 步：先问三个问题

在看任何公式之前，先记住这三个问题。整节课就是在回答它们：

```
❓ 问题 1：为什么给电机通上电，它要转？  →  转矩从哪来
❓ 问题 2：为什么"电流"能控制"转矩"？   →  控制量从哪来
❓ 问题 3：为什么不能通直流，非要换相？ →  FOC 存在的理由
```

**先给结论，再讲道理：**

| 问题 | 一句话答案 |
|---|---|
| 为什么转 | 定子电流造出一个**电磁铁**，去推转子上的**永磁铁** |
| 怎么控 | 转矩 ∝ 定子磁场与转子磁场的**夹角 × 电流大小** |
| 为什么要换相 | 因为转子在转，夹角**一直在变**。不换相，夹角很快就停在 90° 以外，转矩掉到 0 甚至变负 |

> 记住"**夹角**"这两个字。整门 FOC 课，从头到尾都在干一件事：**把定子磁场的夹角，始终维持在 90°。**

---

## 第 2 步：电机的身体构造

### 2.1 定子（不动的那半）

定子上嵌着**三组绕组**（线圈），按空间上互差 **120° 电角度**排布：

```
           U 相（绕在 0°）
                ↑
                │
   W ←──────────┼──────────→ V
   （240°）      │       （120°）
```

**三个关键词，逐个抠：**

1. **绕组 = 电磁铁。** 一根导线通电，周围就产生磁场；绕成很多圈的线圈，磁场就叠加变强。**给绕组通电，等于在定子上"点"了一个电磁铁。**
   
2. **"120° 电角度"是空间角度。** 意思是：如果 U 相线圈的磁极中心在表盘的 0 点，V 相就在 4 点钟方向，W 相在 8 点钟方向。**这三个线圈在空间上是错开的，不是叠在一起的。**

3. **三相绕组接成星形（Y 型）。** 三个绕组有一个公共端点叫**中性点 N**，通常**不引出**（你的板子就是三根线 U/V/W，没有第四根线）。

> 关于第 3 点，有一个非常重要的推论，先记下来，第 4 课会用到：
>
> **星形无中线 → 三相电流之和恒等于 0。**
> 因为电流只能从 U/V/W 三根线进出，没有别的路。从 N 点流出的电流必须等于流入的：
> $$i_a + i_b + i_c = 0$$
> **这意味着三个电流里只有两个是独立的** —— 这是后面"三个量能变成两个量"（Clarke 变换）的物理原因。

### 2.2 转子（会动的那半）

你的 C2208 是**永磁转子**：转子上贴着永磁体，本身就是一块**固定不变的磁铁**。

```
   定子：电磁铁（强弱、方向 由你控制 ← 电流）
   转子：永磁铁（强度固定，方向 跟着转子转）
```

**所以电机是一个"可控的电磁铁" 去推 "一块固定磁铁"。**
这就是整门课的全部物理。剩下的都是数学和工程细节。

---

## 第 3 步：⭐ 为什么通电之后它会停在一个位置（而不是一直转）

做个小实验的想象版：**给 U 相通恒定直流，让它自己去。**

会发生什么？

```
时刻 t=0        定子磁场指向 0°，转子还歪在一边
                → 转子受到转矩，开始旋转  ✅

几十毫秒后      转子的 N 极转到定子 S 极正前方
                → 夹角 = 0°，转矩 = 0
                → 转子【停在那里不动了】❌
```

**重点：它不是坏了，它是"吸住了"。** 就像你把两块磁铁吸在一起，它们就静止了。

**这是一个"定位/自锁"状态，不是电机。** 通电后嗡嗡响但不转，就是这个原因。

### 于是结论非常清楚：

> **要让它一直转，定子磁场就必须一直跟着转子转。**
>
> 转子转到哪，定子磁场就得跟到哪，而且要**永远领先 90°**（后面 3.4 节证明为什么是 90°）。
>
> **"跟着转子转"这件事，就叫 换相（commutation）。**

而"想知道转子在哪"，就需要**位置传感器**（你的 AS5600）或者**观测器**（无感）。

```
   换相 = 根据"转子位置"，决定"三个绕组各通多少电流"
```

> ⚠️ **这是本节最重要的一句话，请读三遍。**
> **换相的本质不是"开关"，而是"电流分配"。**
>
> 老式 BLDC 六步换相是"分配 + 只用两个状态"，FOC 是"连续地分配"。差别只在于精细程度，本质是同一件事。

---

## 第 4 步：反电动势 —— 第一次遇到"边界"

上一节说"通电让它自己去，它会吸住"。那如果**用手帮它转**呢？

先做一个推导。**定子磁场的方向始终在 0°，转子被牵着转过 θ。**

任何一个时刻，把定子磁场分解成两个分量：

```
        定子磁场 Bs（固定指向 0°）
             │
             │  ← 这个方向上的分量：Bs·cosθ
             │     它把转子【往回拽】（阻碍转动）
             ╱
            ╱  ← 垂直于转子的分量：Bs·sinθ
           ╱      它把转子【往前推】（有用）
        θ ╱
   转子方向
```

- **有用分量** $B_s\sin\theta$ → 产生转矩
- **阻碍分量** $B_s\cos\theta$ → 只会发热，帮倒忙

### 4.1 什么叫"反电动势"

现在换个角度看：转子在转，**永磁体的磁场也在跟着扫过定子绕组**。

按法拉第定律，**穿过线圈的磁通量变化 → 线圈里会感应出电压**：

$$e = -\frac{d\lambda}{dt}\quad(\lambda = \text{磁链} = N\Phi)$$

这个电压**不来自电源，而来自转子自己的运动**，所以叫**反电动势**（Back-EMF, BEMF），符号 $e$。

三个关键性质（先记住，第 8 课采样时会再回来）：

| 性质 | 说明 |
|---|---|
| **它随转速线性增大** | $e \propto \omega$。转得越快，感应电压越高 |
| **它的方向与"驱动电流的方向"相反** | 所以叫"反" —— 它会抵消你的电源电压 |
| **它的波形跟转子位置锁定** | 所以测它就能反推转子位置（这就是无感 FOC 的原理） |

### 4.2 反电动势立刻带来第一个硬约束

给一个绕组加上电压 $U$，回路里有什么？

```
        U（驱动器给的）
   ┌──────┤├──────┐
   │      e（反电动势，反向）│
   │               │
  ─┴─ R           ─┴─ L
  ─┬─             ─┬─
   └───────────────┘
```

回路电压方程（**单相简化版**，第 6 课会写完整版）：

$$U = R\cdot i + e = R\cdot i + K_e\cdot\omega$$

**这解释了三个你一定会遇到的现象：**

1. **电机一转起来，同样的电压下电流就变小了。** 因为 $e$ 顶掉了一部分 $U$。
2. **堵转（$\omega=0$，$e=0$）时电流最大。** 此时 $i = U/R$，全靠电阻限流 —— 这就是"堵转会烧电机"的数学原因。
3. **想转得更高转速，必须给更高电压。** 当 $e$ 逼近 $U$ 时，没电压余量了，转速就到顶。

> **对 FOC 的直接后果：母线电压决定了转速上限。**
> 你的板子是 12V 母线。用 $K_e=0.0796$ V/(rad/s) 粗算：
> $$\omega_{max}\approx\frac{12}{0.0796}\approx 151\ \text{rad/s}\approx 1440\ \text{RPM}$$
> 而电机标称额定转速是 **1800 RPM** —— 注意 1440 < 1800。
> ⚠️ 这个矛盾说明 $K_e$ 的量纲需要实验确认（见课后练习 3）。**但要记住这个结论本身：12V 母线很可能跑不到额定的 1800 RPM，想跑满要么升压到 24V，要么接受转速损失。**

---

## 第 5 步：⭐ 转矩到底和什么有关

这是本节的核心，也是 FOC 全部数学的出发点。

### 5.1 转矩公式的物理版

两个磁场相互作用，转矩为：

$$\boxed{\;T \;\propto\; |B_s|\cdot|B_r|\cdot\sin(\theta)\;}$$

其中：

| 符号 | 含义 | 谁决定 |
|---|---|---|
| $\vert B_s\vert$ | 定子磁场强度 | **电流大小**（你可控）|
| $\vert B_r\vert$ | 转子磁场强度 | **永磁体**（固定，不可控）|
| $\theta$ | 两个磁场之间的夹角 | **转子位置 + 你选的电流方向** |

**从这个式子能一眼看出 FOC 的全部战略：**

```
|Br| 固定，不可控  →  放弃
     ↓
想控制转矩 T，只剩两个旋钮：
     旋钮 A：|Bs|  ← 电流大小
     旋钮 B：θ     ← 电流的"相位"（往哪个方向造磁场）
```

> 🔴 **请特别注意旋钮 B。** 绝大多数 FOC 初学者只盯着"电流大小"，以为电流越大转矩越大。
> **错。θ 不对的话，电流再大也是白费（甚至变成刹车）。** 这就是第 5 课 Park 变换要解决的事。

### 5.2 为什么一定是 90°？

$\sin\theta$ 在 $\theta = 90°$ 时取最大值 1。

| $\theta$ | $\sin\theta$ | 转矩 | 物理现象 |
|---|---|---|---|
| 0° | 0 | **0** | 吸住不动（第 3 步那个状态）|
| 30° | 0.5 | 一半 | 凑合 |
| **90°** | **1** | **最大** | ⭐ **FOC 的工作点** |
| 180° | 0 | 0 | 反着吸住 |
| 270° | −1 | 负最大 | 反向制动（发电）|

**所以一句大白话：FOC 就是"让定子磁场永远比转子磁场超前 90°"。**

- 想让它转 → 保持 90°
- 想反转 → 变成 −90°（超前方向反过来）
- 想要 0 转矩 → 对齐（0°）或干脆不给电流

**还有第 3 个旋钮：转矩的符号（正转/反转）也是通过 θ 的正负来实现的。**
所以严格说 FOC 控制的是**一个二维量**（大小 + 方向），这就是为什么会有 $i_d$ 和 $i_q$ **两个**电流分量 —— 第 5 课会把它讲穿。

### 5.3 完整版：转矩与三相电流的关系

上面是直觉版。严格的推导（配合第 4 课的 Clarke 变换）给出：

$$T = \frac{3}{2}\,p\,\lambda_m\, i_q$$

| 符号 | 含义 | 你的电机取值 |
|---|---|---|
| $p$ | **极对数** | **7** |
| $\lambda_m$ | 永磁磁链（转子磁场强度） | $=K_e$，0.0796 Wb（若 $K_e$ 按相峰值计）|
| $i_q$ | **q 轴电流**（= 产生转矩的那部分电流） | 由你控制 |
| $\frac{3}{2}$ | 系数 | **取决于变换约定**（见下方注意）|

**先把 $p$ 讲清楚 —— 这是最多人栽跟头的地方：**

> **极对数 $p = 7$ 的意思是：转子在空间上转 1 圈，磁场要重复 7 个完整周期。**
>
> 这不是"电机里有 7 块磁铁"这么简单，它的后果是：
> **电流的周期 ≠ 转子的周期。电流跑 7 个周期，转子才转 1 圈。**

| 名称 | 定义 | 关系 |
|---|---|---|
| **机械角** $\theta_m$ | 转子真实转过的角度（你肉眼看到的）| — |
| **电角度** $\theta_e$ | 电流/磁场走的相位 | $\boxed{\theta_e = p\cdot\theta_m}$ |

**⭐ 这决定了整个 FOC 算法的工作频率：**

$$f_e = p \cdot \frac{n_{RPM}}{60}$$

代入 C2208 在 1800 RPM：

$$f_e = 7 \times \frac{1800}{60} = 7\times 30 = \mathbf{210\ Hz}\quad(\text{电频率})$$

$\Rightarrow$ 你的电流环要**每秒复现 210 个周期的正弦波**。用 10kHz 的电流环，每个周期只有 **48 次**更新。

**换算成"每个中断走多少电角度"（写代码时直接要用）：**

$$\Delta\theta_e = p\cdot\omega_m\cdot T_s = 7 \times 188.5 \times 10^{-4} = 0.132\ \text{rad} = \mathbf{7.55°/次}$$

> **第 11 课会看到：这个"每周期只更新 48 次"就是电流环频率必须远高于电频率的原因。**

> ℹ️ **关于那个 $\frac{3}{2}$ 系数（可以先跳过，以后回来查）**
> 它来自变换约定。工程上 FOC 有两种：
> - **2/3 等幅值变换**（$\alpha\beta$ 相量的模 = 相电流幅值）：$T=\frac{3}{2}p\lambda_m i_q$
> - **$\sqrt{2/3}$ 等功率变换**（$P = u_\alpha i_\alpha + u_\beta i_\beta$ 直接成立）：$T=\sqrt{\frac{3}{2}}\cdot p\lambda_m i_q$
>
> **本课统一采用 2/3 等幅值变换**（也是 ST、ODrive、SimpleFOC 的主流选择）：
> 好处是 $|i_{\alpha\beta}|$ 就是你万用表量的那个电流幅值，$\theta$ 和物理角度一一对应，写代码时不容易搞错。
> 👉 **代价：算功率时要自己乘 $\frac{3}{2}$，不能直接用等功率公式。**

### 5.4 数字验证（用你的电机，把公式落地）

为了不让公式飘在空中，全部代进去算一遍。

**① 转矩常数 $K_t$**

$$K_t = \frac{3}{2}\cdot K_e = 1.5 \times 0.0796 = \mathbf{0.119\ N\cdot m/A}$$

> 注意：**$K_t$ 和 $K_e$ 数值上只差 1.5 倍（2/3 变换）**。这是电机学的经典结论（$K_t = 1.5 K_e$ 或 $=K_e$，取决于约定）。
> 所以**反电动势常数和转矩常数本质是同一个数**，只是看待它的角度不同（一个看电压，一个看力矩）。

**② 额定电流下的转矩**

$$T_{rated} = K_t \times 0.8\ \text{A} = 0.119\times 0.8 = \mathbf{0.095\ N\cdot m}$$

**③ 堵转电流（危险值）**

$\omega=0 \Rightarrow e=0$，纯电阻限流。相电阻 $= 21.2/2 = 10.6\ \Omega$（线电阻是两相串联，星形）：

$$i_{stall} = \frac{12\text{V}}{10.6\,\Omega} = \mathbf{1.13\ A}\ (相电流)$$

哇，只有 1.13A？看起来不多。但注意 —— 这是**每相**电流，而且**如果你把 U 相接 12V、V 相接 GND（两相通电）**：

$$i = \frac{12}{21.2} = 0.566\text{ A}$$

**④ 但"堵转"在 FOC 里是另一回事 ⚠️**

FOC 是**电流闭环**：你给 $i_q^* = 4.5$A，控制器会**自动把电压升上去**直到电流真的到 4.5A。

$$U_{needed} = R\cdot i = 10.6\times 4.5 = \mathbf{47.7\ V}$$

**但母线只有 12V！** → 电压饱和 → 电流**永远到不了 4.5A**，只能到 $\frac{12\cdot 0.577}{10.6}\approx 0.65$A 左右（还要扣死区和管压降）。

> **结论：这台电机是"电阻限制"型 —— 12V 母线 + 21.2Ω 线电阻，堵转下最多约 1A 相电流。**
> 而标称"最大电流 4.5A"是**短时峰值**（靠电感 $L\frac{di}{dt}$ 在电流环响应窗口内的动态冲量，或者靠 24V 母线）。
> **这直接影响你的保护阈值设定**：过流保护设 4.5A 基本永远不会触发；**按实际可达的 1~1.5A 去设，才有保护意义。**（第 14 课细讲）

**⑤ 电气时间常数 —— 电流环设计的关键数字**

$$\tau_e = \frac{L_{phase}}{R_{phase}} = \frac{5.3\ \text{mH}}{10.6\ \Omega} = \mathbf{0.5\ ms}$$

对应转折频率：

$$f_c = \frac{1}{2\pi\tau_e} = \frac{1}{2\pi\times 0.0005} = \mathbf{318\ Hz}$$

> **这个 0.5ms 决定了电流环的带宽上限。**
> 你的电流环跑在 10kHz（周期 0.1ms），也就是每个控制周期只走过 $\frac{1}{5}$ 个电气时间常数 —— **控制够快，能做得很激进（PI 的 P 可以给大些）**。
> 反之如果电流环只有 1kHz（周期 1ms = 2 个 $\tau_e$），就必然迟钝、振荡。
> 👉 **这是"为什么电流环要 10kHz"的定量答案，第 6 课会用它算 PI 参数。**

---

## 第 6 步：为什么必须用正弦 —— FOC 的入口

现在回到第 5 步的结论：**要转矩恒定，就要 $\theta$ 恒等于 90°。**

而转子在转（$\theta_m$ 一直在变），所以**你必须让定子磁场跟着它转**。定子磁场由电流决定，所以：

> **三个相电流必须按转子的位置连续变化 —— 也就是"正弦"。**

### 6.1 三种驱动方式的对比

| | 通电方式 | 转矩 | 问题 |
|---|---|---|---|
| **直流有刷** | 机械换向器 | 恒定 | 有电刷磨损（不是 BLDC）|
| **六步方波（梯形）** | 每 60° 换一次，只用两相 | **脉动 ±13%** | 换相处有冲击、噪音、振动 |
| **正弦 FOC（本课）** | 三相都是连续正弦 | **恒定** | 计算量大（要 72MHz 的 MCU 干活）|

**六步换相为什么只能做到 ±13%？**

因为它不是"连续地保持 90°"，而是**每 60° 才调一次**。在一个 60° 区间内，夹角 $\theta$ 从 60° 滑到 120°，$\sin\theta$ 就从 $0.866 \to 1 \to 0.866$ —— **转矩在 $\pm 13.4\%$ 之间波动**，而且每次换相会有一个电流突变（di/dt 冲击）。

**FOC 的做法**：不再"分 6 档"，而是**连续地在任意电角度上造磁场**，让 $\theta$ 死钉在 90°。转矩纹波接近 0。

### 6.2 FOC 的数学描述

要让定子磁场领先转子 90°，三相电流应该这样：

$$\begin{aligned}
i_a &= I_m\cos(\theta_e)\\
i_b &= I_m\cos(\theta_e - 120°)\\
i_c &= I_m\cos(\theta_e - 240°)
\end{aligned}$$

**验算一下第 2 步的那个推论**（$i_a+i_b+i_c=0$）：

$$\cos\theta + \cos(\theta-120°) + \cos(\theta-240°) = 0 \quad\checkmark$$

（用三相对称的正弦和恒为 0 证明。**这说明这套电流分配是"合法"的 —— 不需要中线就能实现。**）

### 6.3 于是有了全课最大的难题 ⭐

看这个式子：**$i_a, i_b, i_c$ 是三个一直在变的正弦量。**

你想用 PI 控制器去跟踪它们 —— **但 PI 控制器追不了正弦。**

回忆控制理论最基本的一条：

> **PI 控制器只能对"直流（常量）"做到无稳态误差。**
> 让它去追一个 210Hz 的正弦，它会**永远滞后一个固定的相位角，而且幅值永远差一点**。
> 电频率越高，追得越差 —— 转速一高，整个控制就崩了。

**这就是 FOC 这门课存在的全部理由：**

```
   问题：PI 控制不了"一直在转的正弦量"
     ↓
   思路：那……能不能换个坐标系，让它在那个坐标系里【变成常量】？
     ↓
   答案：能！ → 这就是 Park 变换（第 5 课）
```

**预告一下 Park 变换做的事**，你现在只要记住这个念头：

- 站在**定子**（静止）上，电流看起来是 210Hz 的正弦 → PI 追不上 ❌
- 站在**转子**（跟着转）上，电流看起来是**一动不动的一个常量** → PI 轻松搞定 ✅

$$i_d,\ i_q = \text{常量}\;(\text{在转子上看})$$

而 FOC 的两个控制目标，在那个坐标系里就是两句大白话：

| 量 | 目标值 | 意思 |
|---|---|---|
| $i_d$ | **恒等于 0** | 磁场分量不要 → 不浪费电流发热 |
| $i_q$ | **由速度环给** | 转矩分量 → 控制转矩 |

> ⭐ **"$i_d = 0$ 控制"就是 FOC 最标准的形态。** 第 5 课讲它为什么成立，第 6 课讲怎么用它。

### 6.4 补充：为什么你的电机特别适合 $i_d=0$

电机转子分两类：

| 类型 | 结构 | 特点 | $i_d=0$ 控制 |
|---|---|---|---|
| **SPM**（表贴式）| 磁铁贴在转子表面 | $L_d \approx L_q$，**没有磁阻转矩** | ✅ **最优**，$i_d=0$ 就是最大转矩/安培 |
| IPM（内置式）| 磁铁埋在转子内部 | $L_d < L_q$，**有磁阻转矩** | ⚠️ 需要给负 $i_d$ 才能榨出更多转矩 |

**你的 C2208 是表贴式（SPM）** → $L_d \approx L_q$ → 磁阻转矩为 0 → **$i_d=0$ 就是最优解，不用做 MTPA 那套复杂东西。**

> 这是"适配你硬件"的简化：**很多教材大篇幅讲的弱磁/MTPA，你这台电机可以直接跳过。** 只有想冲超高速时才需要弱磁（给负 $i_d$ 压低反电动势），而 12V 母线本来也冲不上高速。

---

## 第 7 步：这节课的"坑"清单

> 这些是初学者**一定**会踩的，提前标出来。

| # | 坑 | 正确认识 |
|---|---|---|
| 1 | "电流越大转矩越大" | ❌ **只在 $\theta=90°$ 时成立。** 角度不对，加大电流可能只是发热，甚至制动 |
| 2 | "三相电流是三个独立的量" | ❌ 星形无中线 $\Rightarrow i_a+i_b+i_c=0$，**只有 2 个自由度**。这就是 Clarke 能降维的原因，也是**你只装两个采样电阻就够**的原因 |
| 3 | "只看电流大小，不看方向" | ❌ 转矩有符号。反转 = 把 $\theta$ 从 $+90°$ 变成 $-90°$（或者说 $i_q$ 变号）|
| 4 | **"电角度 = 机械角度"** | ❌ $\theta_e = p\cdot\theta_m$，你的电机 **$p=7$**。**程序里填错极对数 → 电流频率差 7 倍 → 电机只会抖动或堵转，电流巨大** |
| 5 | 忽略 $K_e$ 的量纲（峰值？RMS？线电压？相电压？）| ⚠️ 差 $\sqrt{3}$、差 $\sqrt{2}$、差 2。**一切都以实测为准**（课后练习 3）|
| 6 | 以为"死区不影响" | ⚠️ 1µs 死区在 10kHz（周期 100µs）下 ≈ **1% 的电压损失**，还会引起波形畸变 → 第 7、8 课要补 |

---

## 第 8 步：课后任务

### A. 口述题（用自己的话，不要抄讲义）

1. 为什么通电后转子会停住不动？这是故障吗？
2. "换相"这个词，本质上在分配什么？
3. 为什么 $\theta$ 必须保持 90°？如果保持 60° 会怎样（转矩变成多少）？
4. 你的电机 $p=7$、转 1800 RPM，电频率是多少？10kHz 电流环一个电周期更新几次？
5. 为什么"用 PI 直接控制 $i_a,i_b,i_c$"行不通？

<details>
<summary>自检答案（先自己答完再看）</summary>

1. 定子磁场固定，转子转到 N-S 对齐位置后夹角 0°，$\sin0=0$ → 转矩为 0。**不是故障，是自锁/定位状态。**
2. 分配的是"根据转子位置的三个相电流的**大小和方向**"（相量的幅值和相位）。
3. $\sin60°=0.866$ → 转矩只有最大值的 86.6%，而且会随转子位置在 86.6%~100% 之间波动（这正是六步换相的纹波来源）。
4. $f_e = 7 \times 1800/60 = 210$ Hz；$10000/210 \approx$ **48 次**。
5. 因为 $i_a,i_b,i_c$ 是 210Hz 的正弦量，PI 对正弦输入无法做到零稳态误差 —— 会持续存在相位滞后和幅值衰减，转速越高越糟。

</details>

### B. 计算题（必须动手算，用计算器）

1. 转速 300 RPM 时，电频率和机械频率各是多少？
2. 每相电流幅值 1A 时，理想转矩是多少？（用 $K_t=0.119$）
3. 如果程序里把极对数**错填成 1**（真值 7），在 300 RPM 下控制器会以为电频率是多少？会有什么后果？

<details>
<summary>自检答案</summary>

1. 机械频率 $=300/60=5$ Hz；电频率 $=7\times5=\mathbf{35\ Hz}$。
2. $T = 0.119\times1 = \mathbf{0.119\ N\cdot m}$。
3. 会以为电频率只有 5 Hz（真值 35 Hz）→ 输出电流的频率只有真实的 $\frac{1}{7}$ → 磁场转得比转子慢得多 → 夹角迅速跑偏 → **转矩时正时负 → 剧烈抖动、电流飙升、堵转**。这就是"极对数填错"的典型症状。

</details>

### C. 实物作业（动手，用你的板子和万用表）

**① 量线电阻，验证星形假设**

用万用表量电机任意两根引出线之间的电阻，应该是 **21.2Ω** 左右（= 两相串联）。

- 若是 **≈10.6Ω** → 说明 21.2 记的是相电阻，**讲义里所有"线电阻/相电阻"的换算要反过来**。
- 记录实测值：__________ Ω

**② 反电动势实验（⭐ 这个最重要，它同时验证了 $K_e$ 和 $p$）**

1. 把电机三根线**悬空**（不接驱动器），用**手或电钻**匀速转动转子
2. 用示波器量**任意两线之间**的电压（线电压）
3. 观察波形并记录：
   - 波形是**正弦**（→ PMSM）还是**梯形/平顶**（→ BLDC）？
   - 转动一圈，波形有几个周期？（**应该 = 极对数 $p$ = 7**）→ 这是**验证极对数最快的方法**！
   - 在已知转速下的峰峰值：__________ V

**用这个数据反推 $K_e$ 的正确量纲：**

$$K_e[\text{相峰值}] = \frac{V_{pp}/(2\sqrt{3})}{\omega_m},\qquad \omega_m = 2\pi\frac{n_{RPM}}{60}$$

**有了实测 $K_e$，本节所有数字（转矩常数、转速上限、电流环参数）都能校准到真值。**
（如果 ① ② 做不了 —— 电机不在手边或没有示波器 —— 告诉我，第 9 课有一次"用 MCU 自己当示波器"的替代做法。）

---

## 第 9 步：下一课预告

这节课搞清楚了"**为什么要换相**"和"**FOC 的控制目标是什么**"。

但还有一个巨大的空白：**怎么"造"出那个能被精确控制的定子磁场？**

```
   我要求"定子磁场指向 37°、强度 0.8"
        ↓
   这三根线（U/V/W）上，到底要给什么电压？
        ↓
   而 MCU 只会干一件事：【输出高低电平】
        ↓
   ？？？
```

**下节课（第 2 课：三相桥怎么"做出"正弦）回答：**

- 一个半桥只有"上管通/下管通"两种状态 → **怎么造出 0~12V 之间连续可变的电压？**
- 答案：**PWM + 电感滤波**。为什么占空比 $D$ 就等于 $\frac{U_{out}}{U_{dc}}$？
- 八个开关状态（$2^3$）对应八个电压矢量 → 它们在空间上长什么样？
- 死区时间到底造成了什么误差（这是你板子上真实存在的 1µs）
- 为什么**下管必须能"续流"**，以及电感在这里扮演的角色

> 💡 第 2 课会用到第 1 课的两个结论：**「$\theta$ 是可控旋钮」** 和 **「星形无中线 → 三电流和为 0」**。如果这两条还不顺，先回去把第 3、5 步重读一遍。

---

## 附：本节关键公式速查

$$\theta_e = p\cdot\theta_m \qquad\qquad f_e = p\cdot\frac{n_{RPM}}{60}$$

$$T \propto |B_s||B_r|\sin\theta \qquad\text{(FOC 要 }\theta = 90°)$$

$$T = \frac{3}{2}\,p\,\lambda_m\,i_q = K_t\, i_q,\qquad K_t = \frac{3}{2}K_e$$

$$i_a+i_b+i_c = 0 \qquad\text{(星形无中线)}$$

$$U = R\,i + K_e\,\omega \qquad\text{(单相，解释堵转/高速限流)}$$

$$\tau_e = \frac{L}{R} = 0.5\text{ ms}\;(f_c = 318\text{ Hz}) \qquad \text{(电流环设计的基准)}$$

$$\begin{cases} i_d \to 0 \\ i_q \to \text{速度环输出} \end{cases} \qquad\text{(FOC 的两个目标，第 5 课实现)}$$
