longhialberto677-gif/stm32f103-foc/硬件/pcb_picture/6fde4a3d7922f28e4e465c85429b46e6.png

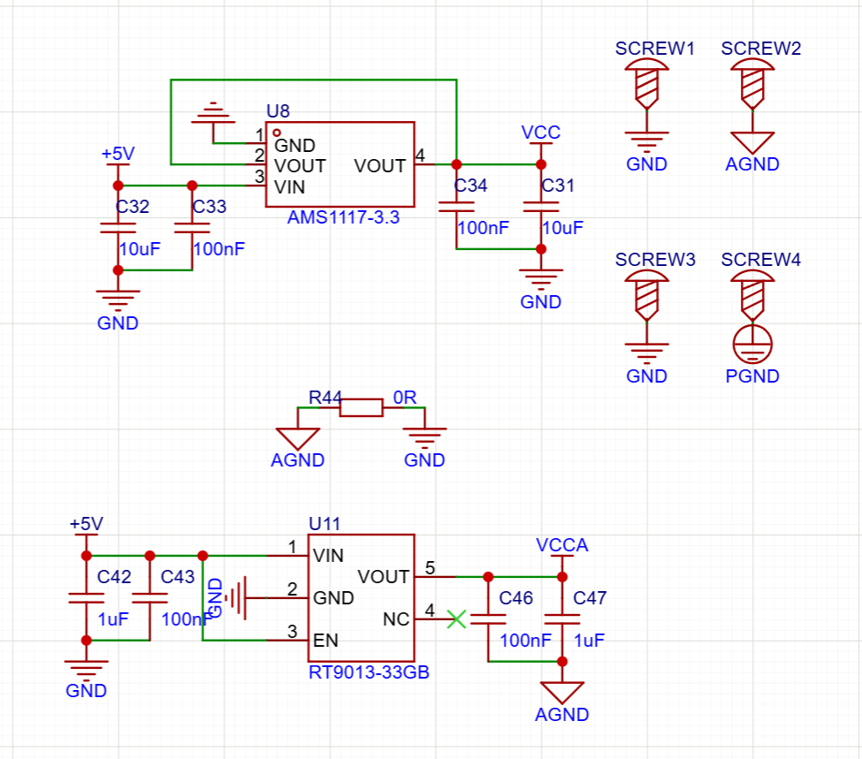
硬件/pcb_picture/6fde4a3d7922f28e4e465c85429b46e6.png
