longhialberto677-gif/stm32f103-foc/硬件/pcb_picture/aa0b5c53c0d9f452b2ae87d95a9ee7c1.png

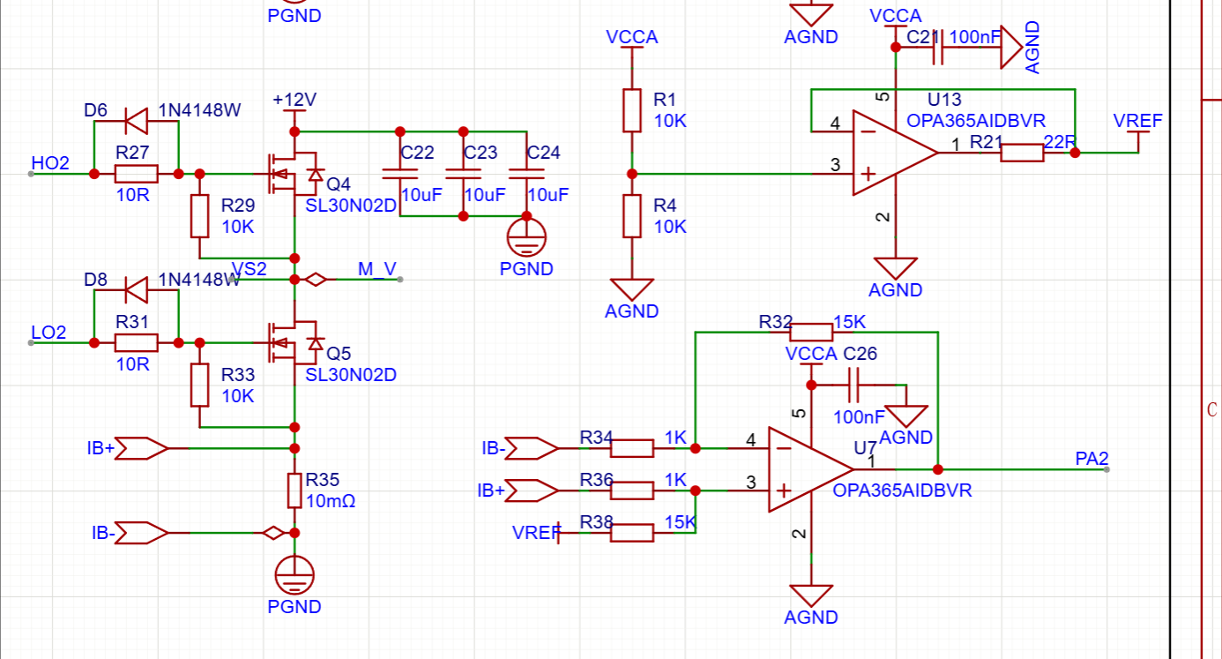
硬件/pcb_picture/aa0b5c53c0d9f452b2ae87d95a9ee7c1.png
