longhialberto677-gif/stm32f103-foc/硬件/pcb_picture/c35e27a6aa78ea748034155119681f92.png

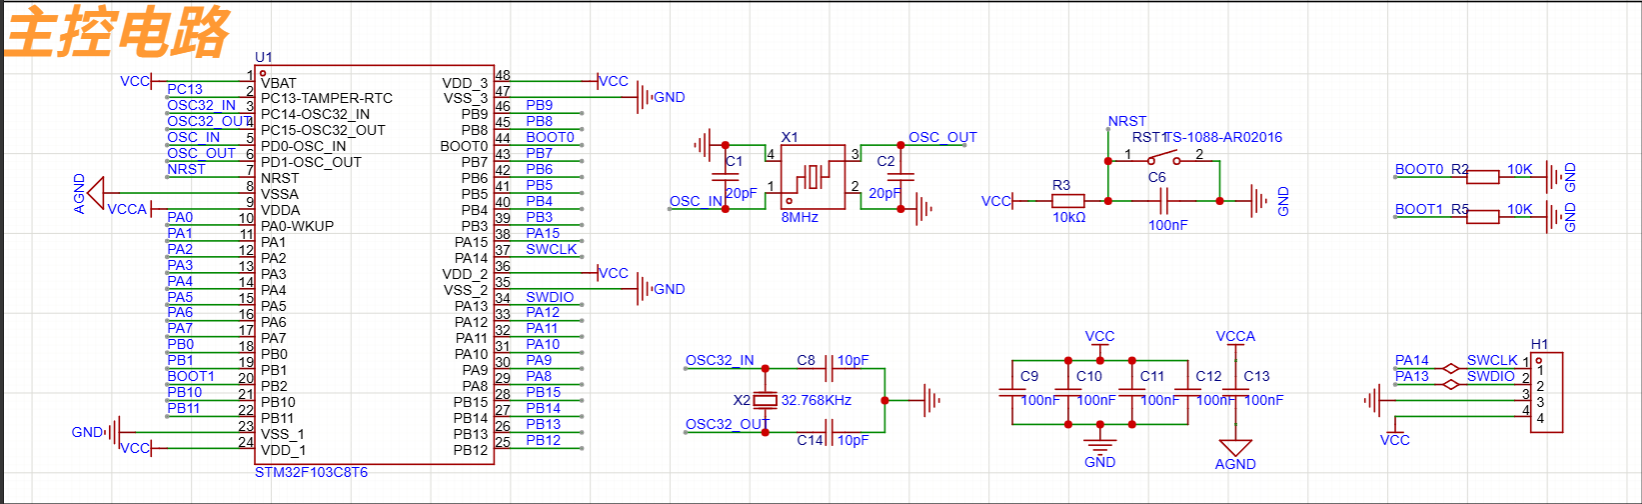
硬件/pcb_picture/c35e27a6aa78ea748034155119681f92.png
