longhialberto677-gif/stm32f103-foc/硬件/pcb_picture/e1af9a8c19cd4dcd61c89c55b2f3f83b.png

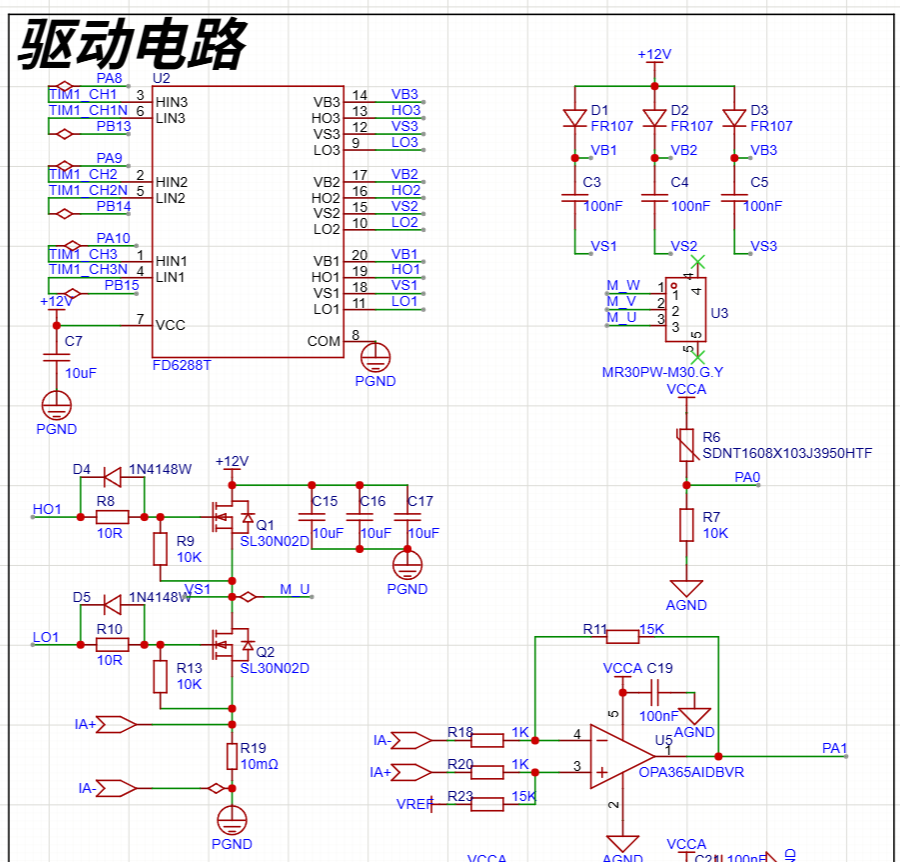
硬件/pcb_picture/e1af9a8c19cd4dcd61c89c55b2f3f83b.png
