longhialberto677-gif/stm32f103-foc/硬件/pcb_picture/e21a35e8880599ce2be51403b14e0b2d.png

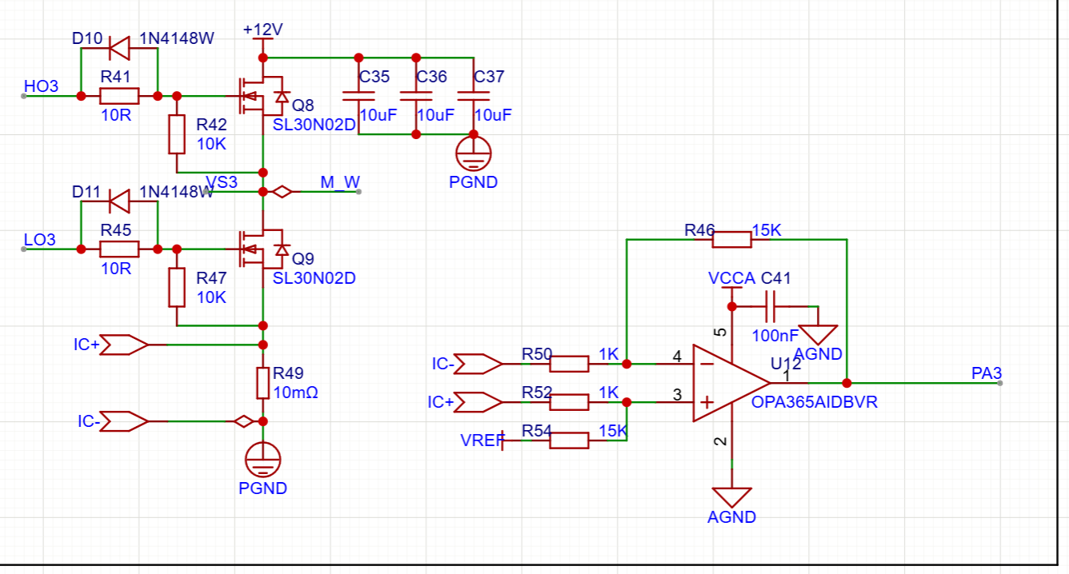
硬件/pcb_picture/e21a35e8880599ce2be51403b14e0b2d.png
