longhialberto677-gif/stm32f103-foc/硬件/pcb_picture/e54ff0daa6bd0e9b3de3a17f9ec3bbb6.png

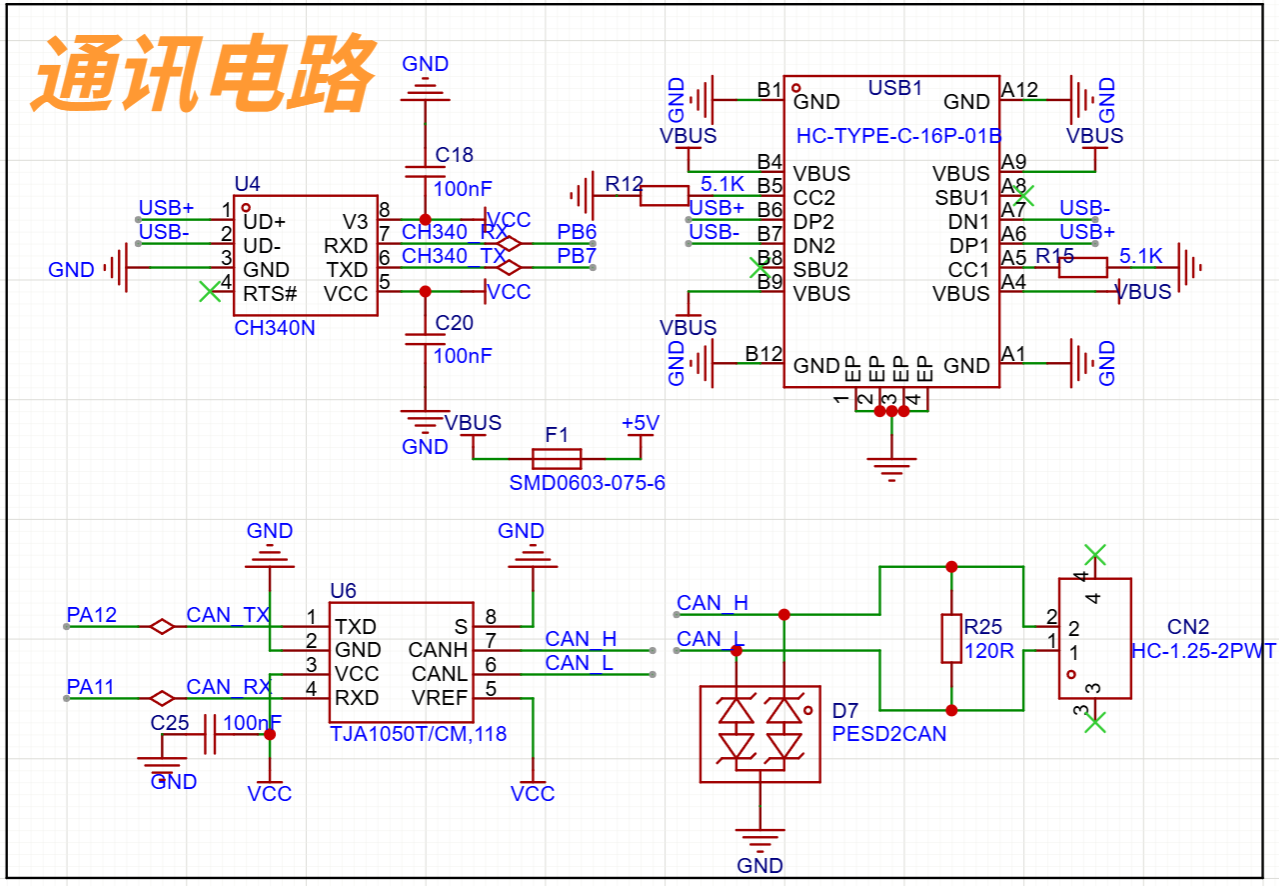
硬件/pcb_picture/e54ff0daa6bd0e9b3de3a17f9ec3bbb6.png
