longhialberto677-gif/stm32f103-foc/硬件/pcb_picture/e7456c365a64f61ac7c5df97c0b1317d.png

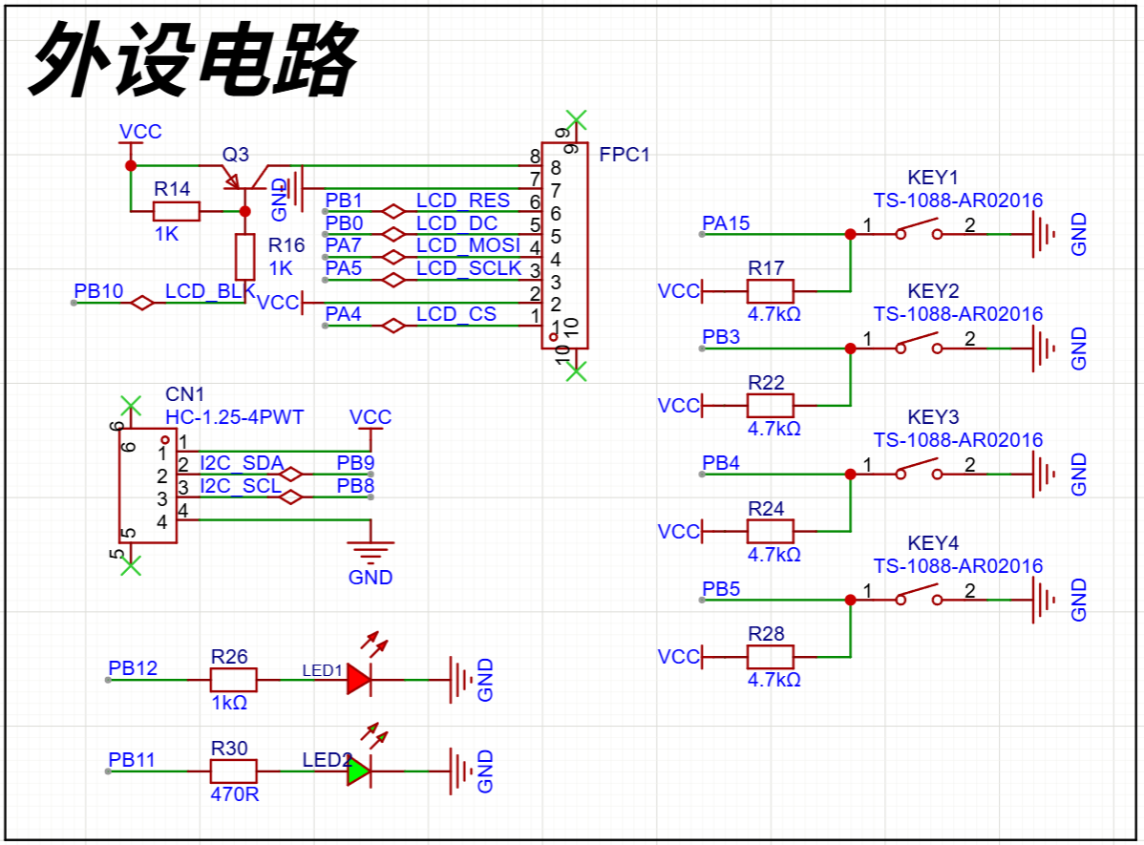
硬件/pcb_picture/e7456c365a64f61ac7c5df97c0b1317d.png
