longhialberto677-gif/stm32f103-foc/硬件/pcb_picture/eae43bc7c83d356b13b3b1f6405f5b68.png

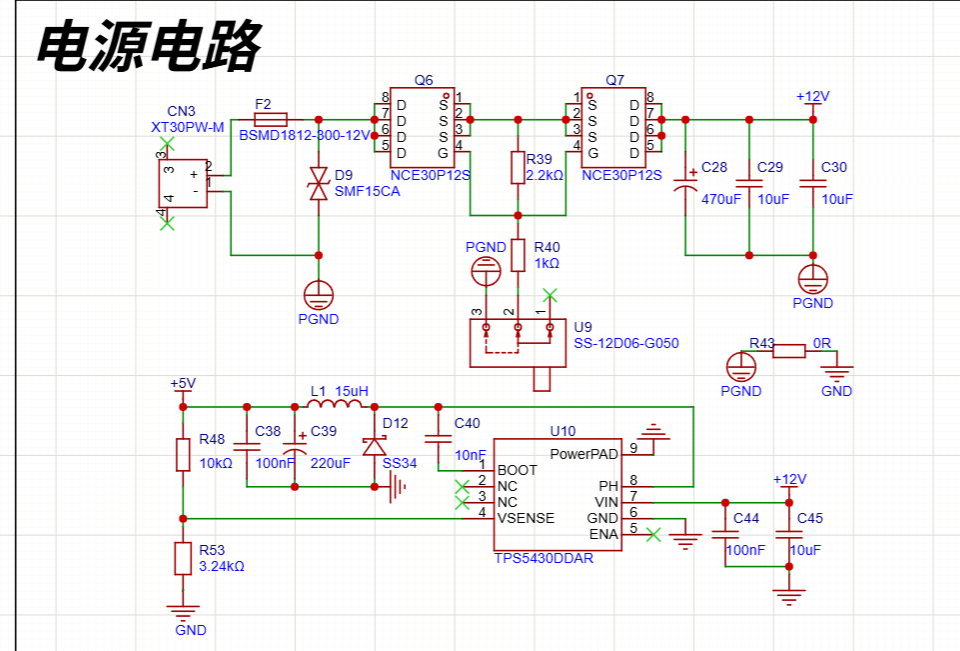
硬件/pcb_picture/eae43bc7c83d356b13b3b1f6405f5b68.png
