longhialberto677-gif/stm32f103-foc/硬件/讲义/05-练手项目/99-备查资料/39c5ed45ee2a6b574988f05499e16dfc.png

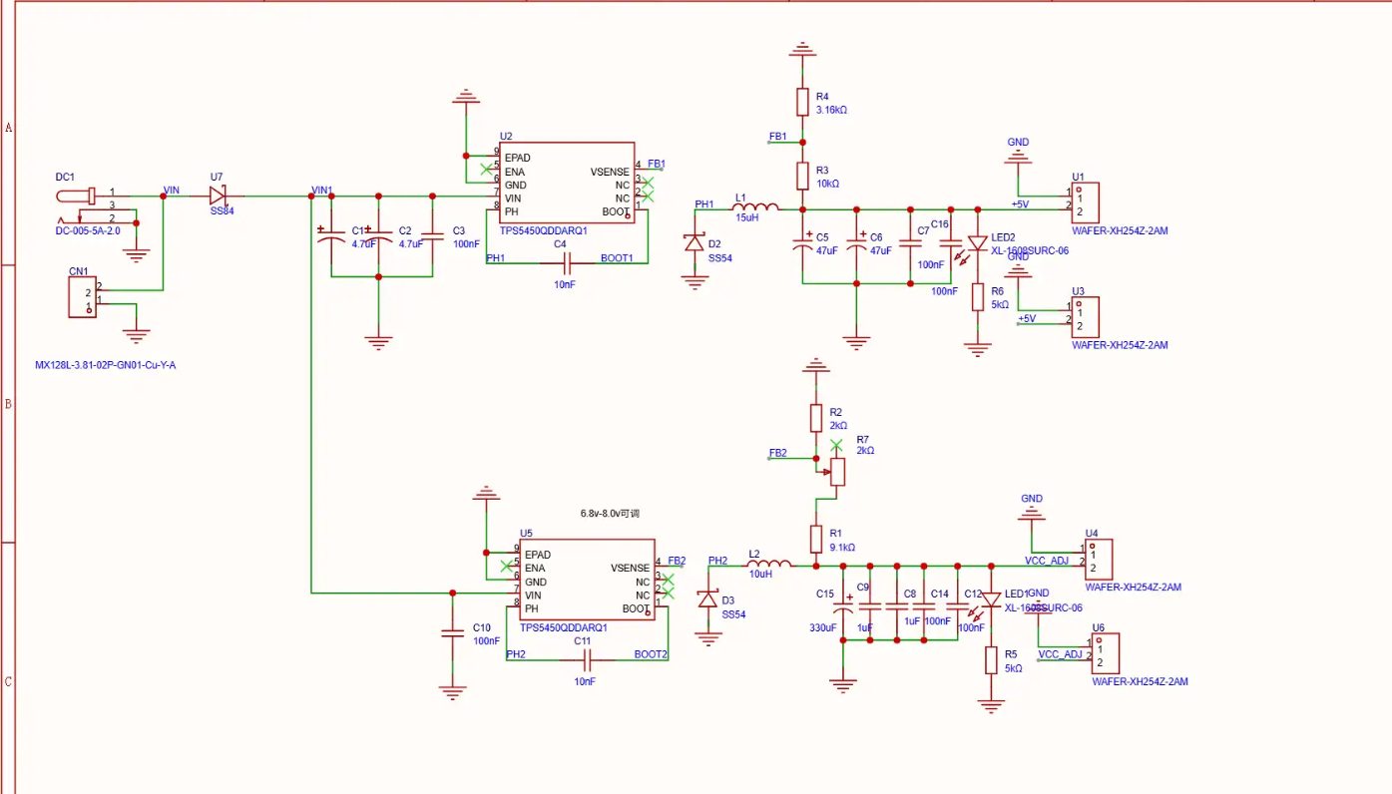
硬件/讲义/05-练手项目/99-备查资料/39c5ed45ee2a6b574988f05499e16dfc.png
