longhialberto677-gif/stm32f103-foc/硬件/讲义/05-练手项目/99-备查资料/06-BOM清单.md

# 通用可调降压模块 —— BOM（最终版）

> 输入 6~24V（满载下限 6.5V）｜ 输出 5V/3A、3.3V/3A、可调 5~12V/3A
> 所有取值都来自计算：`03-设计参数核对表.md`、`04-浪涌与保险丝计算.md`
> ⚠️ 已包含第 1 步的修正：**P-MOS 用背靠背（每路 2 颗，共 4 颗）**

---

## 一、输入级（保护链）

| 位号 | 元件 | 规格 / 搜索词 | 封装 | 数量 | 为什么这么选 |
|---|---|---|---|---|---|
| **F1** | 自恢复 PTC | 保持 6A / 跳闸 12A / 耐压 ≥30V<br>搜索：`PTC 自恢复保险丝 6A 30V` | 直插（径向） | 1 | 最坏稳态输入 5.9A（12V 满载）；PTC 50°C 降额到 80% |
| **Q1a/Q1b** | P-MOS（DC 座路） | **AO4407A**（30V/12A/13mΩ）<br>备选 40V：SI4459BDY / DMP4015SK3 | SOP-8 | 2 | **背靠背**才挡得住反接（单颗挡不住） |
| **Q2a/Q2b** | P-MOS（端子路） | 同上 | SOP-8 | 2 | 两路都要独立做 OR + 反接保护 |
| **R1~R4** | 电阻 | 100kΩ ±1% | 0603 | 4 | 把 4 颗栅极拉到 0V（Vgs 为负才导通） |
| **D1** | TVS | **SMBJ33A**（V_RWM=33V，V_C≈53.3V）<br>⚠️ 买前对一下你买的那家的手册 | SMB（DO-214AA） | 1 | V_RWM 必须 > 24V×1.25=30V；放 P-MOS 之后 |
| **J1** | DC 母座 | `DC-005-2.0`（中心针 2.0mm = 配 5.5×2.1 插头） | 插件 3 脚 | 1 | 丝印标 `中心正极 ≤2A` |
| **J2** | 接线端子 | `KF2EDGK-5.08-2P`（插拔式母座，配公头） | 插件 5.08mm | 1 | 丝印标 `≤6A` |

## 二、三路降压（每路一套，把 U1/U2/U3 换成对应值）

| 位号 | 元件 | 规格 / 搜索词 | 封装 | 数量 | 说明 |
|---|---|---|---|---|---|
| **U1/U2/U3** | 降压芯片 | **TPS5430DDAR**（3A，5.5~36V）<br>或 TPS5450DDAR（5A，引脚兼容） | SOIC-8 + EPAD | 3 | 必须焊好底部散热焊盘 |
| **L1**（5V 轨） | 功率电感 | **15µH**，Isat ≥ **4.5A**，**屏蔽型**，DCR ≤ 40mΩ | 6×6mm 或 7×7mm | 1 | 纹波 0.53A，峰值 3.26A |
| **L2**（3.3V 轨） | 功率电感 | **10µH**，Isat ≥ **4.5A**，屏蔽型 | 6×6mm | 1 | 纹波 0.57A，峰值 3.28A |
| **L3**（可调轨） | 功率电感 | **15µH**，Isat ≥ **5A**，屏蔽型 | 7×7mm | 1 | 12V 档纹波 0.80A，峰值 3.40A |
| **D2/D3/D4** | 续流二极管 | **SS34**（3A/40V 肖特基）<br>→ 想更保险用 SS54（5A/40V） | SMB / SMA | 3 | ⭐ **必须肖特基**，不能用 1N4007 |
| **C_boot×3** | 自举电容 | **10nF** / 50V **X7R**（TPS5450 改用 0.1µF） | 0603 | 3 | 接在 BOOT 与 PH 之间 |
| **C_in×6** | 输入陶瓷 | **10µF** / **50V** **X7R** | 0805 / 1210 | 6 | 每颗芯片 2 颗，**紧贴 VIN 引脚** |
| **C_in100n×3** | 输入陶瓷 | **100nF** / 50V X7R | 0603 | 3 | 高频去耦 |
| **C1** | 输入电解 | **470µF** / **35V**，105°C 规格 | 直插 φ10mm | 1 | 24V 输入必须 ≥35V 档 |
| **C_out 5V** | 输出陶瓷 | **47µF** / 10V X7R | 1210 | 2 | 纹波 1.4mV |
| **C_out 3.3V** | 输出陶瓷 | **47µF** / 10V X7R | 1210 | 2 | 纹波 1.5mV |
| **C_out 可调** | 输出 | **100µF/25V 电解 + 22µF/25V X7R** | 直插 + 1210 | 1+1 | 可调轨电压范围宽，耐压按 25V |
| **C_out100n×3** | 输出陶瓷 | 100nF / 50V X7R | 0603 | 3 | 每路一颗 |

## 三、反馈分压（1% 精度，E96 系列）

| 轨 | R_top | R_bot | 实际输出 | 误差 | 位号建议 |
|---|---|---|---|---|---|
| **5V** | **10kΩ** | **3.24kΩ** | 4.990V | −0.2% | R5 / R6 |
| **3.3V** | **5.1kΩ** | **3.0kΩ** | 3.297V | −0.1% | R7 / R8 |
| **可调轨 主分压** | **10kΩ** | **2.0kΩ** | 7.33V（基准档） | — | R9 / R10 |
| 可调轨 12V 档 | — | 并联 **2.61kΩ** + 跳线 | 12.00V | +0.2% | R11 + JP1 |
| 可调轨 9V 档 | — | 并联 **7.32kΩ** + 跳线 | 8.99V | −0.1% | R12 + JP2 |
| 可调轨 5V 档 | — | 直接用 **1.2kΩ** 当 R_bot | 4.94V | −1.2% | R13（与 R10 二选一焊） |

> ⚠️ **必须 1% 精度**。5% 的碳膜电阻会让输出偏出 ±1.5%。
> 分压电阻统一用 0603 封装。可调轨用"固定电阻 + 跳线切档"，**不要用电位器**。

## 四、输出接口与指示

| 位号 | 元件 | 规格 | 数量 | 说明 |
|---|---|---|---|---|
| **J3/J4** | 输出端子 5V | XH2.54-2P 或 KF2EDGK-5.08-2P | 2 | 丝印 `5V / 3A`（红字） |
| **J5/J6** | 输出端子 3.3V | 同上 | 2 | 丝印 `3.3V / 3A`（绿字） |
| **J7/J8** | 输出端子 可调 | 同上 | 2 | 丝印 `ADJ 5~12V / 3A（跳线选档）` |
| **LED1~3** | 指示灯 | 0805 贴片 LED（红/绿/黄各一） | 3 | 每路一个"这路活了"指示 |
| **R14** | 限流电阻（5V 轨） | **1kΩ** | 1 | 5V 下约 3mA |
| **R15** | 限流电阻（3.3V 轨） | **1kΩ** | 1 | 3.3V 下约 1.7mA |
| **R16** | 限流电阻（可调轨） | **3.3kΩ** | 1 | 12V 下约 3mA（⚠️ 不能用 1k，会过流） |

## 五、使能（可选，但建议做）

| 位号 | 元件 | 规格 | 数量 | 说明 |
|---|---|---|---|---|
| **R17~R19** | 上拉电阻 | 100kΩ | 3 | VIN → ENA |
| **C11~C13** | 延时电容 | 100nF | 3 | ENA → GND，做上电错峰 |

> TPS5430 的 ENA 悬空即"使能"，但三路同时上电会一起拉扯输入电容。
> 加 RC 延时（约 10ms）可让三路错开启动。想做"级联上电"就串成
> `5V 稳了 → 才拉高 3.3V 的 ENA`。

## 六、机械

| 位号 | 元件 | 规格 | 数量 |
|---|---|---|---|
| H1~H4 | 安装孔 | φ3mm（M3 螺丝） | 4 |
| —— | 扎带孔 | 用于压住 DC 座本体，防翘焊盘 | 2 |

---

## 七、下单前自查（照着勾）

```
[ ] 电解电容：耐压 ≥35V（24V 输入）  ← 用 25V 会爆浆
[ ] 陶瓷电容：全部 X7R 或 X5R，【不能是 Y5V】
[ ] 电感：全部是【屏蔽型】，Isat 都 ≥4.5A
[ ] 续流二极管：SS34/SS54 肖特基，不是 1N4007
[ ] P-MOS：4 颗（不是 2 颗），两路各背靠背一对
[ ] 反馈电阻：全部 1% 精度
[ ] TVS：V_RWM ≥30V（SMBJ33A），别买成 24V 的
[ ] PTC：保持电流 6A（不是 3A、不是 4A）
[ ] 芯片：TPS5430DDAR / TPS5450DDAR，带 EPAD 的 SOIC-8
[ ] 可调轨的跳线/焊桥：至少 2 个档位
```

## 八、成本估算（单件，约数）

| 类别 | 金额 |
|---|---|
| 3 颗 TPS5430 | ~9 元 |
| 4 颗 AO4407A | ~2 元 |
| 3 个电感 | ~6 元 |
| 电容（全部） | ~8 元 |
| 二极管 + TVS + PTC | ~3 元 |
| 接口 + 端子 + 电阻 + LED | ~10 元 |
| PCB（5×5cm 双面，打样摊薄） | ~3 元 |
| **合计** | **≈ 41 元** |
