longhialberto677-gif/stm32f103-foc/软件/调试记录/img/04-单通道I7放大-马鞍波形状验证.png

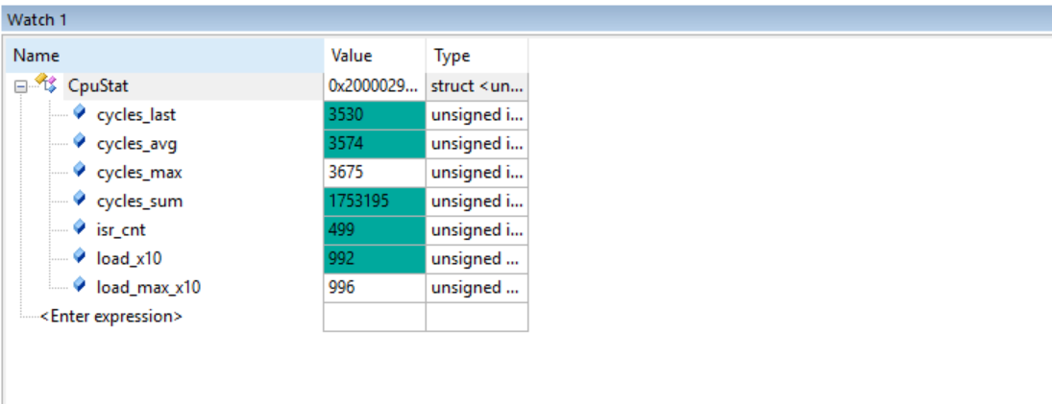
软件/调试记录/img/04-单通道I7放大-马鞍波形状验证.png
