longhialberto677-gif/stm32f103-foc/Core/Src/main.c

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
/* Includes ------------------------------------------------------------------*/
#include "main.h"
#include "dma.h"
#include "i2c.h"
#include "tim.h"
#include "usart.h"
#include "gpio.h"

/* USER CODE BEGIN Includes */
#include "bsp_system.h"
/* USER CODE END Includes */


void SystemClock_Config(void);
/**
  * @brief  The application entry point.
  * @retval int
  */
int main(void)
{

  /* MCU Configuration--------------------------------------------------------*/

  /* Reset of all peripherals, Initializes the Flash interface and the Systick. */
  HAL_Init();

  /* Configure the system clock */
  SystemClock_Config();

  /* Initialize all configured peripherals */
  MX_GPIO_Init();
  MX_DMA_Init();
  MX_USART1_UART_Init();
  MX_TIM1_Init();
  MX_I2C1_Init();
  /* USER CODE BEGIN 2 */
  CpuStat_Init();
  scheduler_init();
  Motor_StateMachine_Init(&MotorSystem);
  /* USER CODE END 2 */

  /* Infinite loop */
  /* USER CODE BEGIN WHILE */
  while (1)
  {
	/* 编码器限频到 1kHz。400kHz 下每次读约 0.12ms → 约 12% CPU
	 * 千万不要每圈都读：阻塞式读会把主循环的时间全吃掉 */
	static uint32_t enc_tick = 0;
	if((HAL_GetTick() - enc_tick) >= 1U)
	{
		enc_tick = HAL_GetTick();
		uint16_t data = AS5600_ReadData();
		if(data != 0xFFFF)                 /* 读失败就不更新角度 */
		{
			Encoder_UpData(&MotorSystem.Encoder,data);
			/* 打时间戳 + 解算实测转速 + 原子发布给中断（角度预测用）*/
			Encoder_Speed_Update(&MotorSystem.Encoder,DWT->CYCCNT);
		}
	}
	  scheduler_run();
	  Vofa_Send_Task();
    /* USER CODE END WHILE */

    /* USER CODE BEGIN 3 */
  }
  /* USER CODE END 3 */
}

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
