longhialberto677-gif/stm32f103-foc/Core/Inc/main.h

#define led_green_Pin GPIO_PIN_11
#define led_green_GPIO_Port GPIOB
#define led_red_Pin GPIO_PIN_12
#define led_red_GPIO_Port GPIOB
#define KEY1_Pin GPIO_PIN_15
#define KEY1_GPIO_Port GPIOA
#define KEY2_Pin GPIO_PIN_3
#define KEY2_GPIO_Port GPIOB
#define KEY3_Pin GPIO_PIN_4
#define KEY3_GPIO_Port GPIOB
#define KEY4_Pin GPIO_PIN_5
#define KEY4_GPIO_Port GPIOB
