longhialberto677-gif/stm32f103-foc/myapp/sincos.c

#include "sincos.h"


/* ============================================================================
 * 正弦表: sin_tab[i] = sin(2*pi*i/1024)，i = 0..1023
 * 由 tools/gen_sin_tab.py 自动生成，请勿手改
 * ==========================================================================*/
const float sin_tab[SIN_TAB_SIZE] =
{
    0.0000000f, 0.0061359f, 0.0122715f, 0.0184067f,
    0.0245412f, 0.0306748f, 0.0368072f, 0.0429383f,
    0.0490677f, 0.0551952f, 0.0613207f, 0.0674439f,
    0.0735646f, 0.0796824f, 0.0857973f, 0.0919090f,
    0.0980171f, 0.1041216f, 0.1102222f, 0.1163186f,
    0.1224107f, 0.1284981f, 0.1345807f, 0.1406582f,
    0.1467305f, 0.1527972f, 0.1588581f, 0.1649131f,
    0.1709619f, 0.1770042f, 0.1830399f, 0.1890687f,
    0.1950903f, 0.2011046f, 0.2071114f, 0.2131103f,
    0.2191012f, 0.2250839f, 0.2310581f, 0.2370236f,
    0.2429802f, 0.2489276f, 0.2548657f, 0.2607941f,
    0.2667128f, 0.2726214f, 0.2785197f, 0.2844075f,
    0.2902847f, 0.2961509f, 0.3020059f, 0.3078496f,
    0.3136817f, 0.3195020f, 0.3253103f, 0.3311063f,
    0.3368899f, 0.3426607f, 0.3484187f, 0.3541635f,
    0.3598950f, 0.3656130f, 0.3713172f, 0.3770074f,
    0.3826834f, 0.3883450f, 0.3939920f, 0.3996242f,
    0.4052413f, 0.4108432f, 0.4164296f, 0.4220003f,
    0.4275551f, 0.4330938f, 0.4386162f, 0.4441221f,
    0.4496113f, 0.4550836f, 0.4605387f, 0.4659765f,
    0.4713967f, 0.4767992f, 0.4821838f, 0.4875502f,
    0.4928982f, 0.4982277f, 0.5035384f, 0.5088301f,
    0.5141027f, 0.5193560f, 0.5245897f, 0.5298036f,
    0.5349976f, 0.5401715f, 0.5453250f, 0.5504580f,
    0.5555702f, 0.5606616f, 0.5657318f, 0.5707807f,
    0.5758082f, 0.5808140f, 0.5857979f, 0.5907597f,
    0.5956993f, 0.6006165f, 0.6055110f, 0.6103828f,
    0.6152316f, 0.6200572f, 0.6248595f, 0.6296382f,
    0.6343933f, 0.6391244f, 0.6438315f, 0.6485144f,
    0.6531728f, 0.6578067f, 0.6624158f, 0.6669999f,
    0.6715590f, 0.6760927f, 0.6806010f, 0.6850837f,
    0.6895405f, 0.6939715f, 0.6983762f, 0.7027547f,
    0.7071068f, 0.7114322f, 0.7157308f, 0.7200025f,
    0.7242471f, 0.7284644f, 0.7326543f, 0.7368166f,
    0.7409511f, 0.7450578f, 0.7491364f, 0.7531868f,
    0.7572088f, 0.7612024f, 0.7651673f, 0.7691033f,
    0.7730105f, 0.7768885f, 0.7807372f, 0.7845566f,
    0.7883464f, 0.7921066f, 0.7958369f, 0.7995373f,
    0.8032075f, 0.8068476f, 0.8104572f, 0.8140363f,
    0.8175848f, 0.8211025f, 0.8245893f, 0.8280450f,
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
};

/* ============================================================================
 * 一次取出 sin/cos
 * cos(a) = sin(a + 90度)，而 90 度正好是表的 1/4 圈 = 256 个索引，
 * 所以 cos 不需要第二张表，索引偏移 256 即可（1024 点表时 SIN_TAB_SIZE/4）
 * ==========================================================================*/
void Foc_SinCos_U16(uint16_t angle, float *ps, float *pc)
{
    uint16_t idx  = angle >> SIN_TAB_FRAC_BITS;
    uint16_t frac = angle &  SIN_TAB_FRAC_MASK;
    uint16_t i_s  = idx;
    uint16_t i_c  = (idx + (SIN_TAB_SIZE / 4)) & SIN_TAB_MASK;
    float    k    = (float)frac * (1.0f / 64.0f);

    *ps = sin_tab[i_s] + (sin_tab[(i_s + 1) & SIN_TAB_MASK] - sin_tab[i_s]) * k;
    *pc = sin_tab[i_c] + (sin_tab[(i_c + 1) & SIN_TAB_MASK] - sin_tab[i_c]) * k;
}
