longhialberto677-gif/stm32f103-foc/myapp/bsp_system.h

#ifndef __BSP_SYSTEM_H__
#define __BSP_SYSTEM_H__


#include "main.h"
#include "dma.h"
#include "i2c.h"
#include "tim.h"
#include "usart.h"
#include "gpio.h"


#include "string.h"
#include "stdio.h"
#include "math.h"

#include "sincos.h"

#include "Hardware_Driver.h"
#include "Motor_Config.h"
#include "scheduler.h"
#include "led_app.h"
#include "key_app.h"
#include "Vofa.h"
#include "FocAlgorithm.h"
#include "interrupt.h"
#include "test.h"
#include "Encoder.h"
#include "TdTrakcer.h"



#endif
