longhialberto677-gif/stm32f103-foc/(commit log)

2026-10-09 chore: 初始化仓库，收录 STM32F103 FOC 学习资料与驱动代码
    从零学习无刷电机 FOC 驱动的完整记录：硬件设计讲义 + 软件算法笔记
    + CubeMX 工程 + Keil 工程 + Simulink 仿真模型。
    内容组织：
    - 硬件/ 17 篇主课讲义、专题、小测、PCB 布线课程，以及 8 张原理图截图
    - 软件/ 14 课 FOC 算法课程骨架（已完成第 1 课）
    - myapp/ 应用层代码：FocAlgorithm、Hardware_Driver、调度器、Vofa 波调
    - Core/ Drivers/ CubeMX 生成的 HAL 初始化与 ST 官方库
    - 仿真/ SVPWM Simulink 模型
    - tools/ 正弦表生成脚本
    工程配置：
    - .gitignore 排除 Keil 编译产物（约 40MB）与 J-Link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
2026-10-09 feat: 加入 DWT 中断占用率观测，并记录 20kHz FOC 中断饱和现象
    观测代码（myapp/test.c / myapp/test.h）：
    - 用 Cortex-M3 内核 DWT->CYCCNT 直接数 TIM4 中断的执行周期数
    - 占用率 = 中断周期数 / 周期预算（72MHz / 20kHz = 3600 cycle）
    - hook 放在 TIM4_IRQHandler 的 USER CODE 区（入口 IsrBegin / 出口 IsrEnd）
    - CpuStat_Init 在 Motor_StateMachine_Init 之前调用，保证 DWT 先于中断使能
    实测结论：
    - cycles_avg = 3573 / 3600 = 99.25%，cycles_max = 3675（已超过预算）
    - 中断体本身约 3518 cycle（97.7%），观测代码仅约 55 cycle（1.5%）
    - 主循环每 50us 的时间片从约 82 cycle 掉到 27 cycle
    表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
2026-10-09 docs: 变更记录改成"一次变更一个文件夹"，并生成图片内嵌的 Word 版
    目录结构：
    - 软件/调试记录/ -> 变更记录/（提到顶层，作为项目级变更日志）
    - 01-中断占用率饱和分析/ 独立成文件夹，内含 .md、.docx、img/
    - 新增 变更记录/README.md（索引 + 目录约定 + 新记录怎么加）
    新增 tools/md2docx.ps1：
    - 直接驱动 Word COM 逐段建文档，图片用 InlineShapes.AddPicture 内嵌
    - 不用 HTML 中转：Word 解析 HTML 里的本地图片不可靠（中文/含空格路径直接
    失败，即使图片改成 ASCII 名也只留空框，word/media 为空）
    - 脚本自带校验：转换后核对 word/media 条目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
2026-10-09 feat: FOC 触发改为 TIM1_CH4 比较中断（弃用独立 TIM4），并修正测量分母
    架构改动：
    - TIM1 增加 CH4 通道（No Output，CCR4=48，中心对齐 ARR=49）
    - FOC 触发点从 TIM4 更新中断改为 TIM1_CH4 比较中断，软件 & 1 分频
    即：进中断 20.408kHz（=载波率），跑 FOC 10.204kHz
    - 删除 HAL_TIM_Base_Start_IT(&htim4)，TIM4 不再产生中断
    - stm32f1xx_it.c 新增 TIM1_CC_IRQHandler，DWT 测量钩子搬到这里
    - myself_foc.ioc 同步：TIM1 Channel4 + NVIC.TIM1_CC_IRQn
    为什么必须改：
    原 TIM4（20.000kHz）与 TIM1 载波（2MHz/(2x49) = 20.408kHz）互质，
    FOC 触发点在载波内的位置持续漂移（每周期挪 1us，2.45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
2026-10-09 perf: SVPWM 三次软浮点除法折成常量，单次 FOC 从 3574 降到 2654 cycle
    改动（myapp/FocAlgorithm.h / FocAlgorithm.c）：
    - Foc_TypeDef 增加两个预存字段 Kpwm、HalfTpwm
    - Set_Udc_Tpwm_Param 里预存 Kpwm = Tpwm/Udc、HalfTpwm = 0.5f*Tpwm
    （全工程唯一一次除法，只在初始化/改参数时做一次）
    - SVPWM_ZeroSqInject 把 (Vm/Udc + 0.5)*Tpwm 展开成 Vm*Kpwm + HalfTpwm，
    每相从 fdiv+fadd+fmul+f2iz 变成 fmul+fadd+f2iz，除法彻底消失
    实测（图见 变更记录/03-除法换倒数/img/）：
    - 单次 FOC：3574 -> 2654 cycle（省 920，即 25.7%）
    反推每次 __aeabi_fdiv 约 307 cycle（约 4.3us），是普通软浮点调用的 4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
2026-10-09 docs: 补齐变更记录 02（触发架构改造）与 03（除法换倒数），含图片内嵌 Word
    02-控制环触发架构改造：
    - 7 处改动清单；为什么用 CH4 而不是更新事件（中心对齐下 UEV 每周期两次）
    - Pulse=48（ARR-1）的用意：让 CCR 写入赶在下一次 UEV 之前
    - 实测 CPU 97.7% -> 53.4%，cycles_last 在 198/3574 交替证明分频在工作
    - VOFA 九通道代数验证（架构换了但数学没动）
    - 4 条遗留：TIM4 死代码、初始化顺序、Keil 编码设置、CH4 触发率靠反推确认
    03-除法换倒数：
    - (Vm/Udc+0.5)*Tpwm 恒等变形为 Vm*Kpwm + HalfTpwm，工程里只剩一次除法
    - 实测单次 FOC 3574 -> 2654 cyc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
2026-10-09 chore: 清理 TIM4 残留代码，并修正初始化顺序
    - 删除 TIM4 全部残留：tim.c 的 htim4/MX_TIM4_Init/MspInit/MspDeInit、
    tim.h 与 stm32f1xx_it.h 的声明、stm32f1xx_it.c 的 TIM4_IRQHandler、
    main.c 的 MX_TIM4_Init() 调用、interrupt.c 里注释掉的死代码
    - myself_foc.ioc: 清掉 TIM4.* 与 functionlistsort 里的 MX_TIM4_Init 条目
    （否则 CubeMX 一重新生成就把 TIM4 带回来）
    - Motor_StateMachine_Init 里把 Set_Udc_Tpwm_Param 提到 Motor_Hardware_Init 之前：
    顺序反了的话，中断刚使能的几个周期里 Kpwm/HalfTpwm 还是 0（Udc=0 会算出 inf），
    上电时电机没转所以无害，但不该依赖这个巧合
2026-10-10 feat: 加入 V/F 开环速度控制（斜坡+角度积分），并修掉角度回绕的双精度 fmod
    V/F 角度生成器（myapp/FocAlgorithm.c / .h）：
    - 新增 Vf_SpeedControl_TypeDef：误差 -> 死区 -> 加速度方向 -> 速度积分 -> 角度积分
    - 新增 Vf_SpeedControl_Param_Init / Vf_SpeedControl_Update 两个接口
    - Motor_StateMachine_Run 里用它替换原来的固定步长角度累加，
    输出接到 state->Foc.Theta / Theta_U16，仍走原有的 反Park -> 反Clark -> SVPWM 通路
    角度回绕修正（关键）：
    - 原来只把"输出"用 fmod 回绕，累加器 Theta_Integrator 无限增长，两个后果：
    ① 双精度 fmod 每周期执行一次，实测约 612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
2026-10-12 feat: 接入 AS5600 编码器（I2C1 重映射 PB8/PB9），完成零点标定
    代码结构（照 G431 工程的分工：读原始值放 Hardware_Driver，角度换算放 Encoder）：
    - 新增 myapp/Encoder.c/.h：Encoder_Typedef（Line/MotorPn/Dir/Pulse_Data/Phase/
    Theta_U16/Theta_e_U16）+ Encoder_Param_Init + Encoder_UpData
    - Hardware_Driver.c 新增 AS5600_ReadData()（对应 G431 的 MT6701_ReadData）、
    AS5600_CheckMagnet()，以及 I2C_BusRecover() 总线恢复
    - Motor_Config.h 新增 ENCODER_LINE(4096) / Pn(7)
    - bsp_system.h 加 i2c.h + Encoder.h；scheduler.h 加 Encoder 成员，并修一处乱码注释
    - main.c 主循环：限频 1kHz 读取 + 读失败保护（不更新角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
2026-10-12 feat: 角度刻度统一（V/F 改 Q16 定点）并接入编码器闭环，三步走完成
    角度路径定点化（FocAlgorithm.h/.c）：
    - V/F 角度积分：float 弧度 + if/else 回绕 → uint32 Q16 累加 + 溢出自动回绕
    - 新增 ANGLE_Q16_PER_RAD，Param_Init 预存 Step_K，每周期只剩 1 次浮点乘
    - 输出改成 uint16_t，与编码器同一套刻度（一圈 = 65536）
    - 好处：回绕零成本、正反转都对（补码回绕）、切角度源无需任何转换
    - 汇编：Vf_SpeedControl_Update 软浮点调用 13 -> 11 -> 9
    - 实测：单次 FOC 1922 -> 1844 cycle（省 78），cycles_max 1926 -> 1848，load 300 -> 289
    事先估算 150~280 偏高；仍差 84 cycle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
2026-10-13 feat: 编码器角度预测（DWT 时间戳 + 实测转速），并清理死代码、波特率提到 460800
    问题：AS5600 一次读 0.12ms > FOC 周期 0.098ms，编码器读取进不了中断，
    角度只能 1kHz 更新，两次采样之间"零阶保持" —— 滞后 = 6·p·n·Δt
    （540rpm 时 22.7°，3000rpm 时 126°）
    实现（myapp/Encoder.c/.h）：
    - DWT 时间戳（13.9ns 分辨率，无符号相减天然处理 32 位回绕）
    - 实测转速：先处理机械角跨圈、再乘增益(65536/Line×Pn=112)，速度用 Q12；
    一阶低通 1/4（编码器 1 计数 = 0.088° 机械，直接差分噪声大）
    - 角度预测（FOC 中断 10kHz）：θ = θ_k + 速度×(now−t_k +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
2026-10-26 feat: 移植微分跟踪器（TD）做 Vq 软启动，并定点化把 CPU 占用从 12.8% 降到 0.45%
    背景：Vq 直接阶跃会让电流突变、电机"啪"一下窜起来。用二阶线性 TD
    （临界阻尼）把它变成平滑的电压上升沿：
    y'' = wn^2*(u-y) - 2*wn*y'
    稳态 y = u，输出是输入的平滑版本，同时白送一阶导 y'（将来速度环可用）。
    定点化（这是重点）：
    - 状态 Q16（电压 x 65536），系数 Q20（让 0.98ms 这种小 Ts 也有足够精度）
    - 离散化时把 Ts 吸收进系数：K1 = wn^2*Ts、K2 = 2*wn*Ts、K3 = Ts
    - 实测（反汇编数出来的）：
    TdTrakcer_Update_Q16 22 条指令，0 次软浮点，约 29 cycl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
